mneuroth/heizungsregelung-public/heatcontrol_firmware/README.md

## Firmware für Heizungsregelung mit Heizungsplatine und Raspberry Pi

Diese Firmware ist aktuell.
