mneuroth/heizungsregelung-public/documentation/SchaltplanHeizungsreglung.odp

RS232 Konverter Platine

MAX3232

UART Konverter

MAX3232

UART Konverter

Conrad Relaiskarte

Vin = 12..24 Volt

Arduino Platine

Arduino

+5V (V_ref)

NTC20

(Sensor)

R2 (11kΩ)

A1..A12 (Analog Input)

PT1000

(Sensor)

R2 (1kΩ||11kΩ),

1kΩ

A0, A9 (Analog Input)

Serial (Pin 0, 1)

Vin = 7..12 Volt

Serial1 (Pin 18, 19)

Digital Out: Pin 13 (on board LED), 7 (external LED), 6 (not used)

+5V (V_ref)

Temperatur Sensoren (13 Stück)

Schaltbare 230V Ausgänge (8 Stück)

230 Volt Platine

Vin = 230 Volt

Vin = 5 Volt

UART2,

Baud=19200,

8bit,

Parity=None

Stop=1,

Timeout=5sec

UART1,

Baud=19200,

8bit,

Parity=None

Stop=1,

Timeout=2sec

Friendly

ARM

UART0, (DEBUG: RS232 9Pin)

Baud=115200,

8bit,

Parity=None

Stop=1,

Timeout=5sec

Vin = 5 Volt

LAN
