mneuroth/heizungsregelung-public/documentation/DokumentationRegelung.pdf

## Regelung Ist Zustand (5.5.2010)

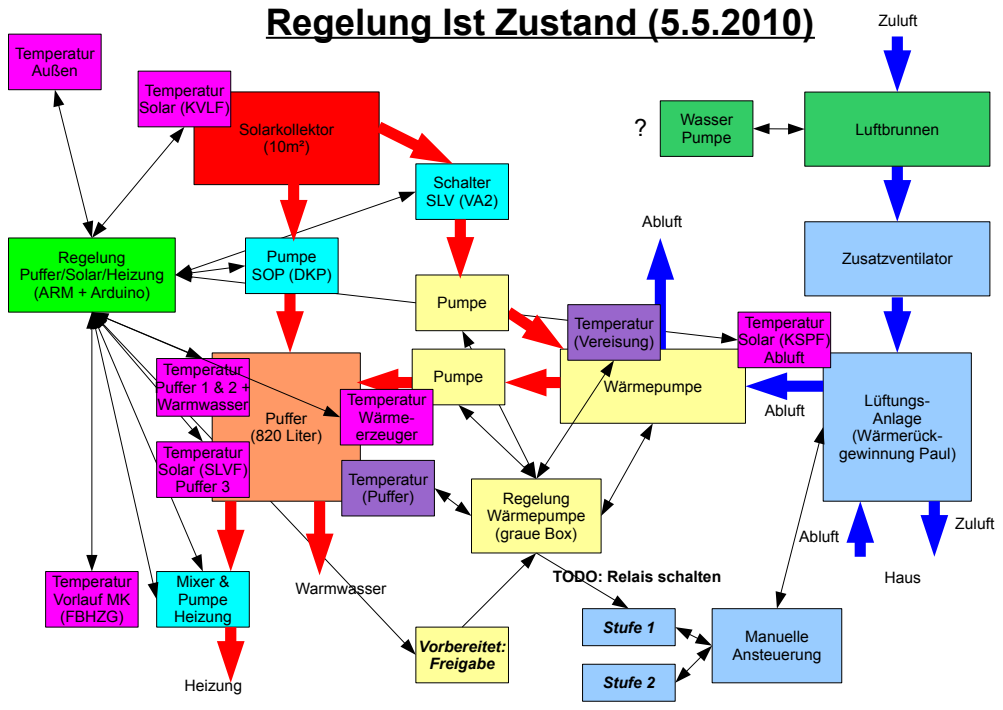
[picture p19: page 1]
Solarkollektor (10m²); Puffer (820 Liter); Wärmepumpe; Lüftungs- Anlage (Wärmerück- gewinnung Paul); Zusatzventilator; Zuluft; Luftbrunnen; Haus; Abluft; Warmwasser; Heizung; Regelung Wärmepumpe (graue Box); Pumpe SOP (DKP); Mixer & Pumpe Heizung; Temperatur Puffer 1 & 2 + Warmwasser; Temperatur Solar (KVLF); Temperatur (Puffer); Pumpe; Temperatur Außen; Manuelle Ansteuerung; Temperatur (Vereisung); Wasser Pumpe ?; Schalter SLV (VA2); Temperatur Solar (KSPF) Abluft; Stufe 1; Stufe 2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

Regelung
Puffer/Solar/Heizung
(ARM + Arduino)

Temperatur erzeuger | Wärme-

Temperatur Solar (SLVF) Puffer 3

TODO: Relais schalten

## Eingänge: Temperatur Sensoren:

ADC-Nr | Name | ID | used
0 | Solar / KVLF (Solar Collector) | SOLAR_KVLF | X
1 | Puffer 3 / SLVF (Solar Buffer 3) | SOLAR_SLVF | X
2 | Außen (Outdoor) | OUTDOOR | (X)
3 | Mixer / Vorlauf MK (FBHZG) (Act. heat) MIXER_HEATING | X
4 | Puffer 1 (Buffer 1) | BUFFER1
5 | Puffer 2 (Buffer 2) | BUFFER2
6 | Abluft / Solar KSPF (Outgoing Air) | HEATPUMP_OUTGOING_AIR
7 | Warmwasser | WARM_WATER
8 | Waermeerzeuger | HEAT_CREATOR
9 | Ingoing Air <not connected yet> | INGOING_AIR
10 | Licht Sensor 1 <not used>
11 | Licht Sensor 2 <not used>
12 | Vereisung
13
14
15

## Ausgänge: Relais:

Relais-Nr | Name | ID
0 | Solar Motor / SOP DKP | MOTOR_SOLAR
1 | Heating Motor | MOTOR_HEATING
2 | Waermepumpe | HEATPUMP
3 | Lueftungsanlage / Bypass | VENTILATION
4 | Ventil Waermepumpe / Solarbetrieb / SLV VA2 HEATPUMP_SOLAR_VALVE
5 | Booster / Warmwasser Zirkulationspumpe | BOOSTER
6,7 | Mixer | MIXER_HEATING

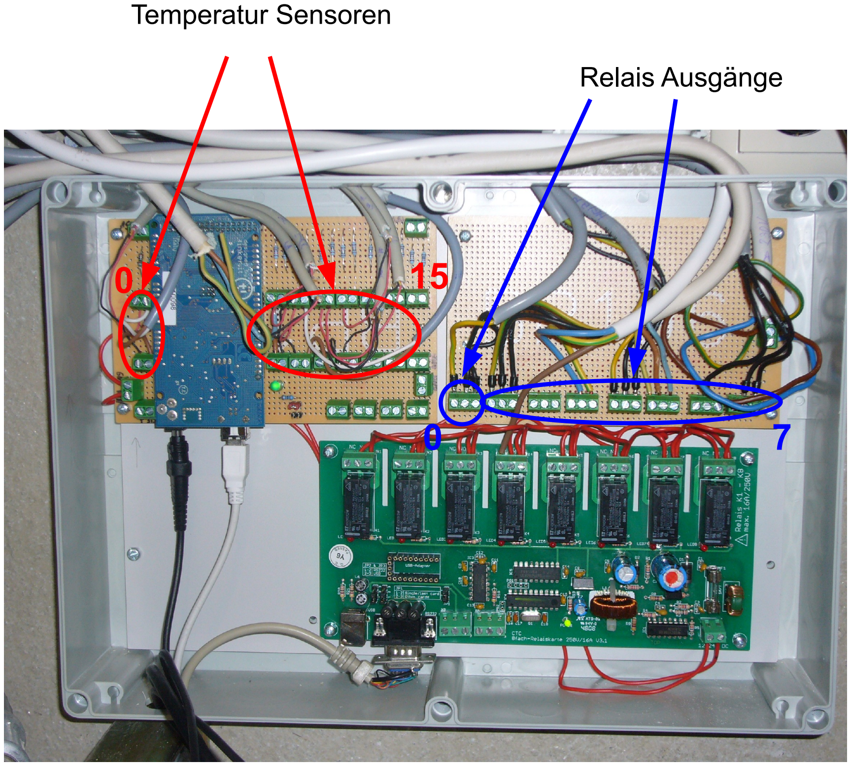
[picture p20: page 4]

Temperatur Sensoren

Relais Ausgänge

0 15

0 7

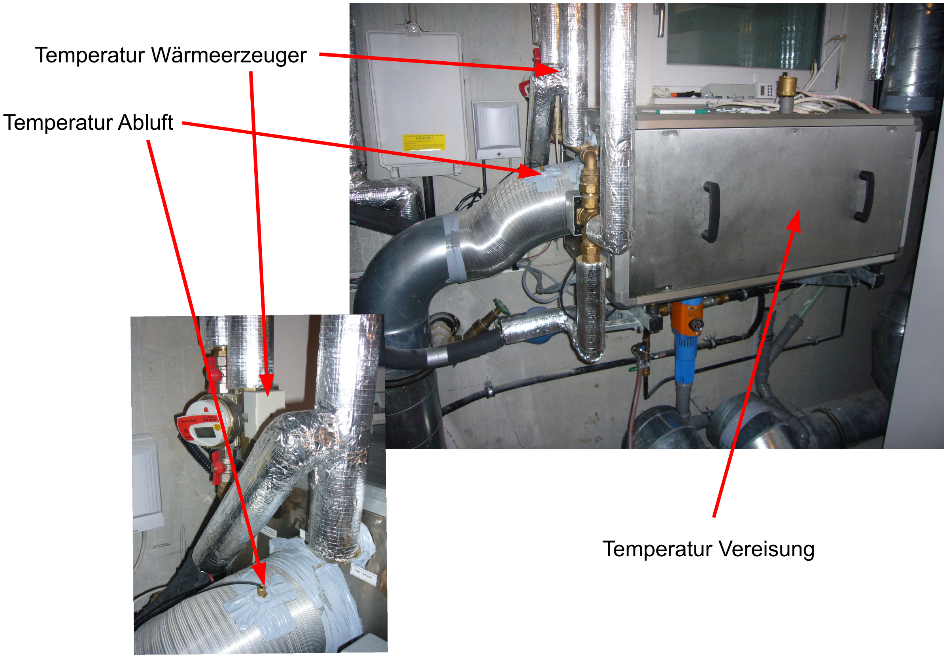
[picture p21: page 5]

Temperatur Wärmeerzeuger

Temperatur Abluft

Temperatur Vereisung

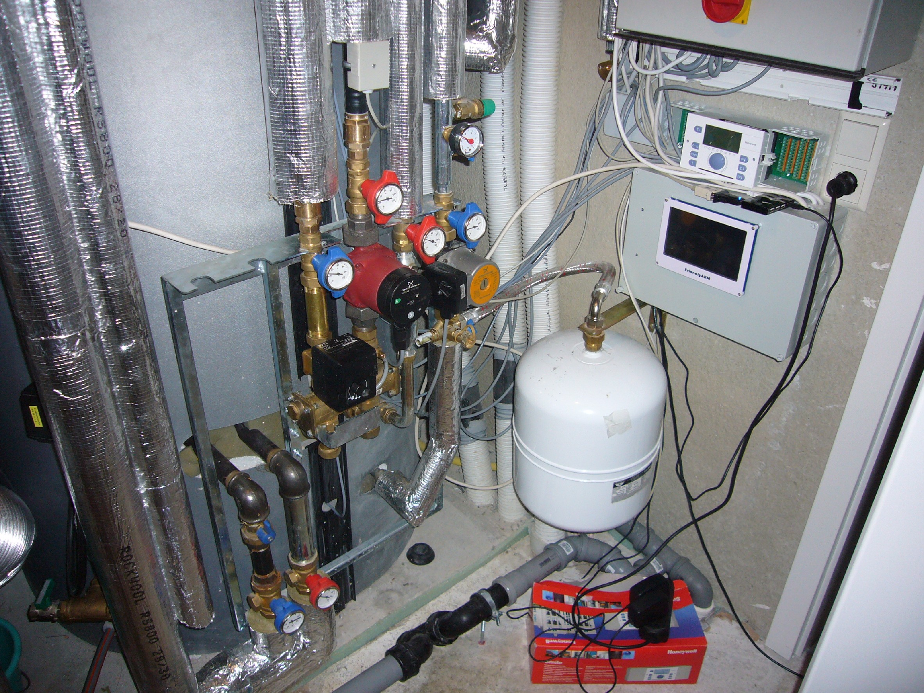
[picture p22: figure]
