mneuroth/heizungsregelung-public/bilder/README.md

## Gesamt System

Foto des gesamten Systems
