mneuroth/heizungsregelung-public/documentation/README.md

## Allgemeine Dokumentation des Heizungsregelungs Projekts

Dieses Verzeichnis enthält Dokumentation und Datenblätter für das Heizungsregelungs Projekt.
