mneuroth/heizungsregelung-public/platine/README.md

## Schaltpläne für die Heizungsregelungs Platine

Programm zur Bearbeitung der Schaltpläne (Stromlaufplan und Layout) muss das Programm [Target3001](https://www.ibfriedrich.com/de/index.html) verwendet werden.
