mneuroth/heizungsregelung-public/strompi2/README.md

# Strompi2

Dieses Verzeichnis enthält die original Dokumentation der [Strompi2 Platine](https://joy-it.net/de/products/rb-StromPi2).
