mneuroth/heizungsregelung-public/documentation/ScanHeizungsregelungDoku.pdf

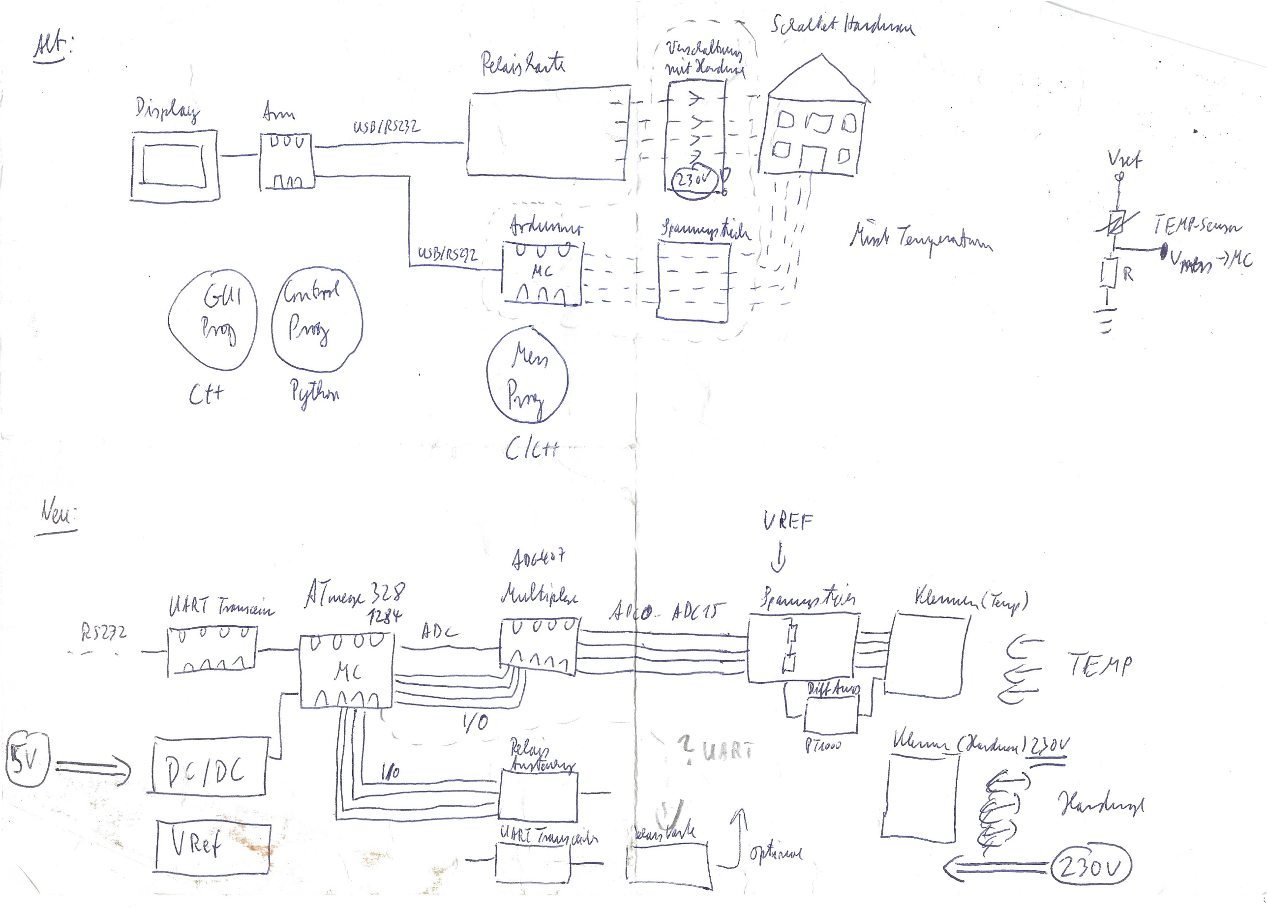
[picture p26: page 1]
