mneuroth/heizungsregelung-public/documentation/Schaltplan230VoltPlatine_Heizungsregelung.pdf

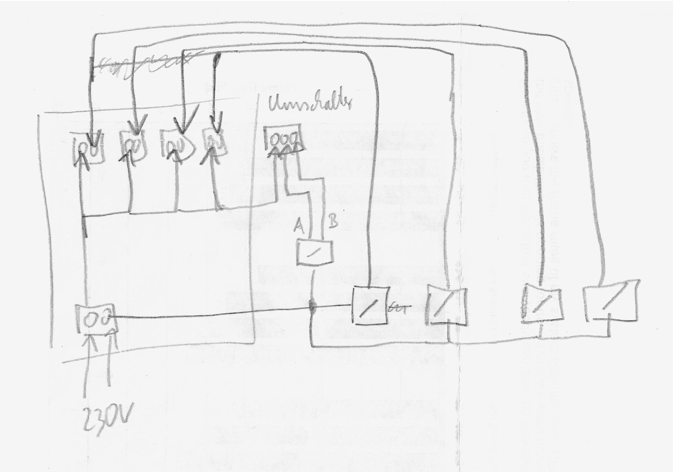
[picture p27: page 1]
