mneuroth/heizungsregelung-public/documentation/SchaltplanUARTConverter_Heizungsregelung.pdf

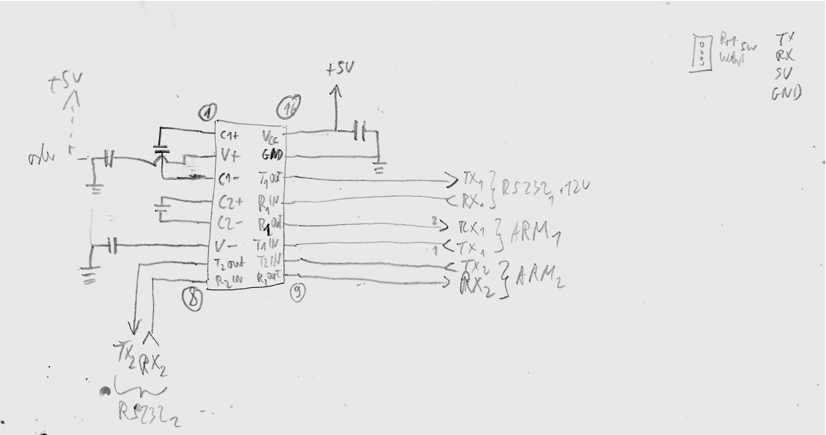
[picture p28: page 1]
