mneuroth/heizungsregelung-public/bilder/http_client_help.png

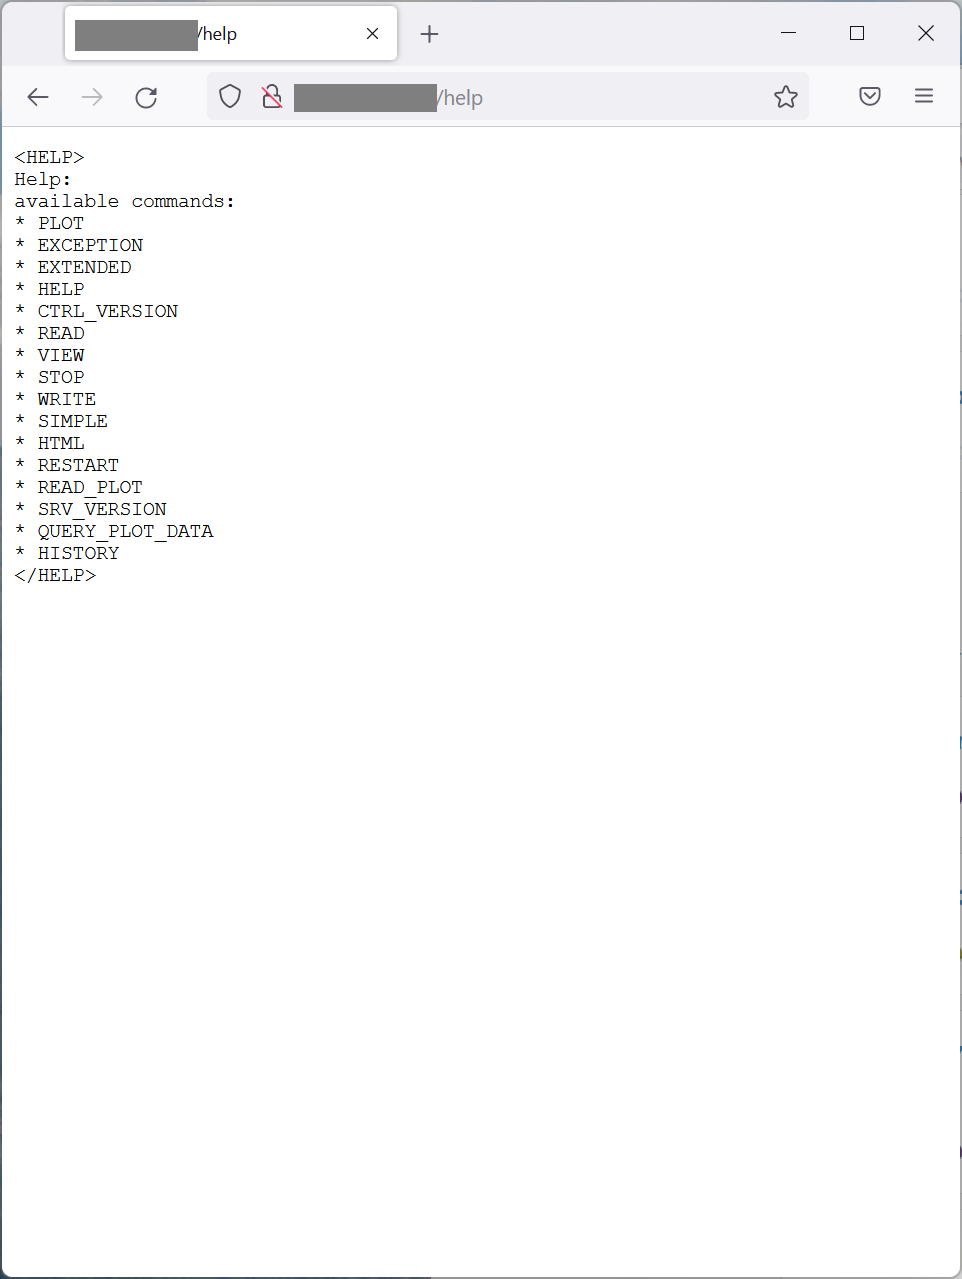
bilder/http_client_help.png
