mneuroth/heizungsregelung-public/bilder/P1100033.JPG

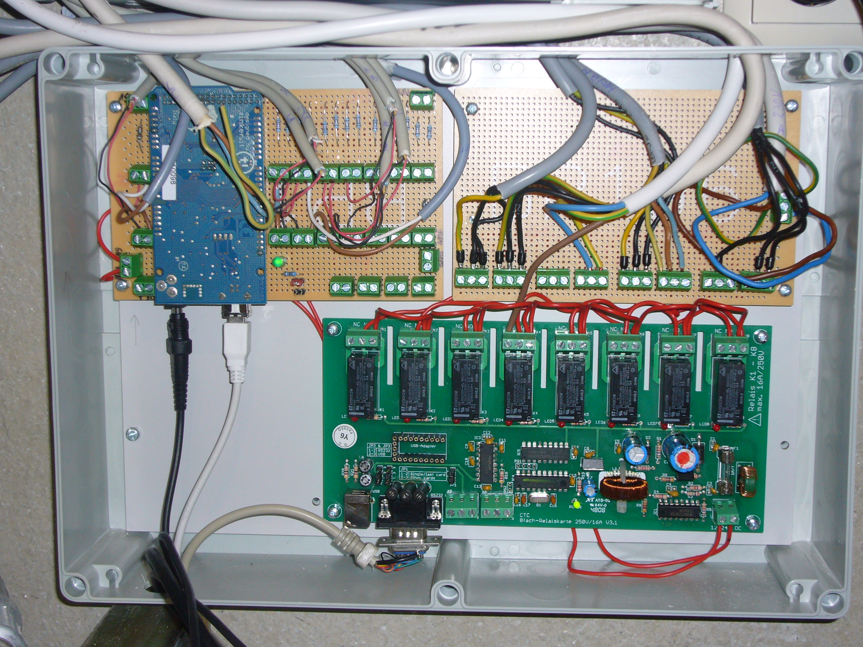
bilder/P1100033.JPG
