mneuroth/heizungsregelung-public/documentation/BlockDiagrammSoftware.png

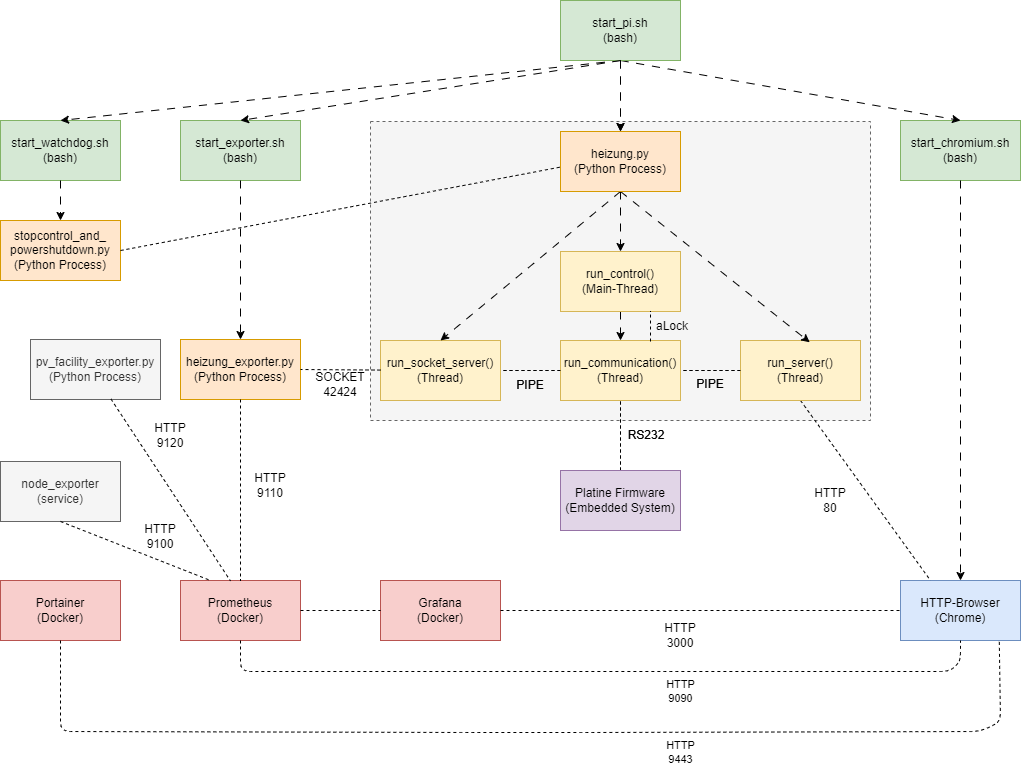
documentation/BlockDiagrammSoftware.png
