mneuroth/heizungsregelung-public/documentation/RegelungIstZustand.png

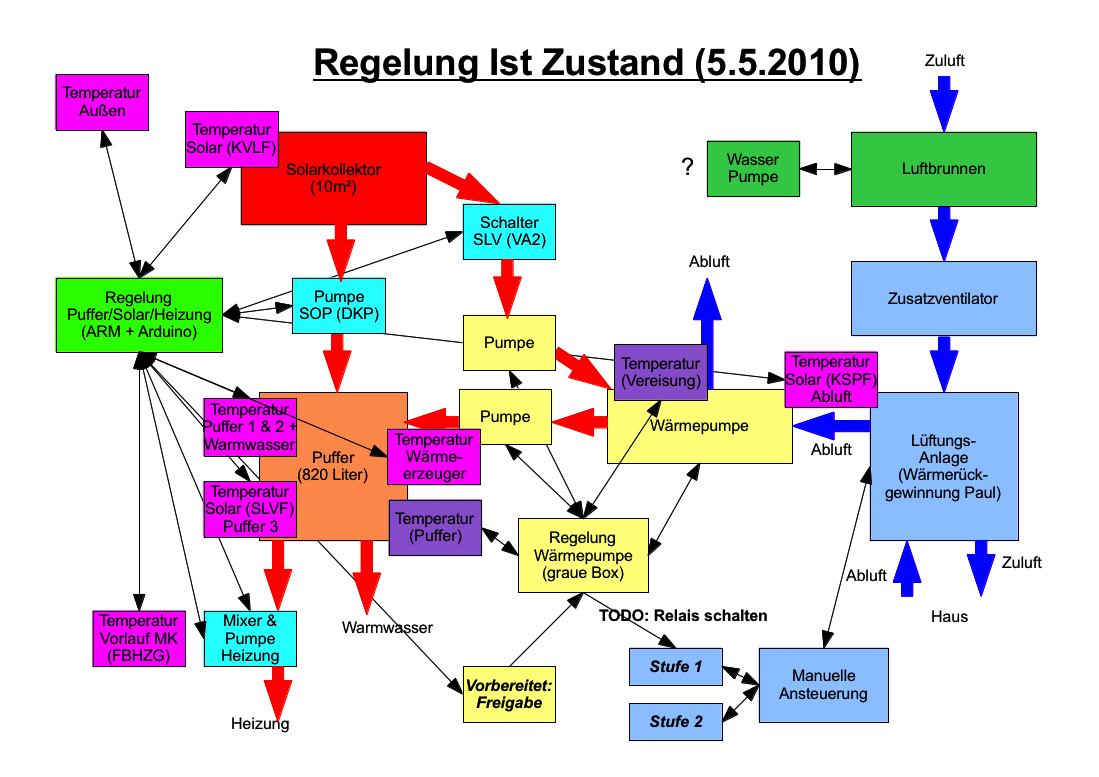
documentation/RegelungIstZustand.png
