mneuroth/heizungsregelung-public/documentation/SchaltplanHeizungsreglung.png

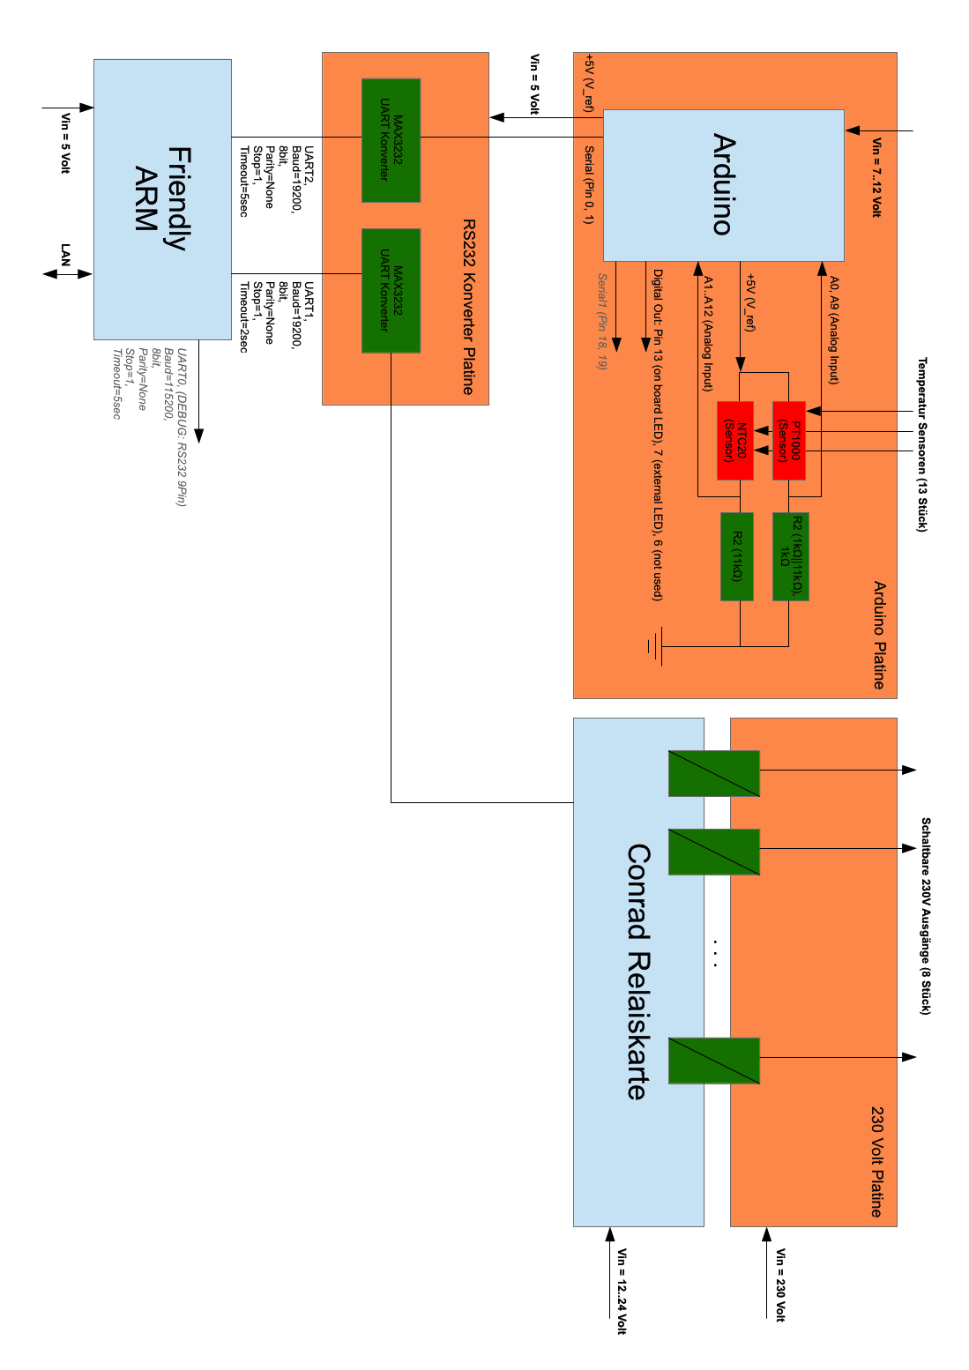
documentation/SchaltplanHeizungsreglung.png
