mneuroth/heizungsregelung-public/documentation/two_spi_devices.png

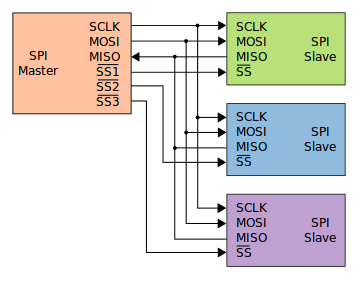
documentation/two_spi_devices.png
