mneuroth/heizungsregelung-public/documentation/VergleichQualityADC_MCP3008_ATMega32_mcp(blue)_with_mcadc(orange)_b.png

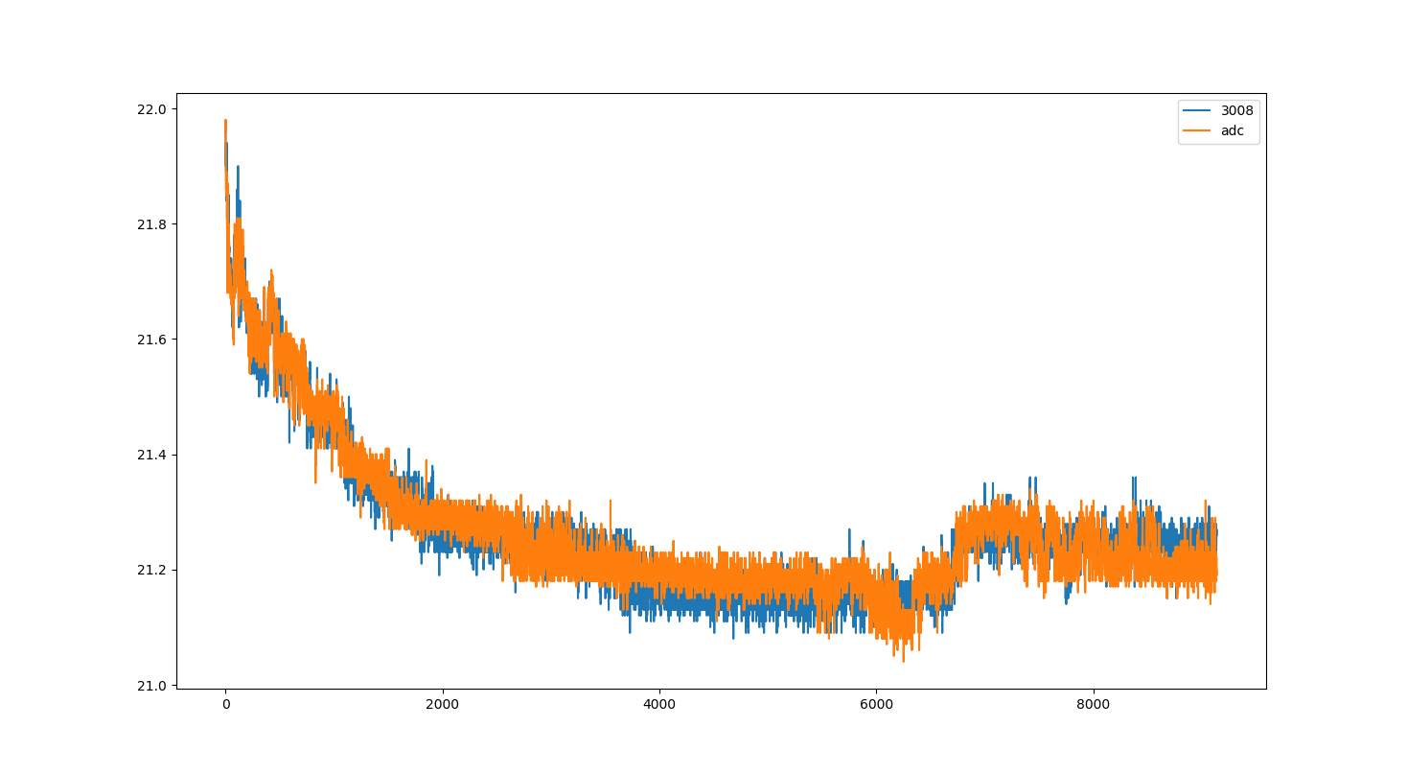
documentation/VergleichQualityADC_MCP3008_ATMega32_mcp(blue)_with_mcadc(orange)_b.png
