mneuroth/heizungsregelung-public/documentation/VergleichQualityADC_MCP3008_normal(blue)_with_averaged(orange)_b.png

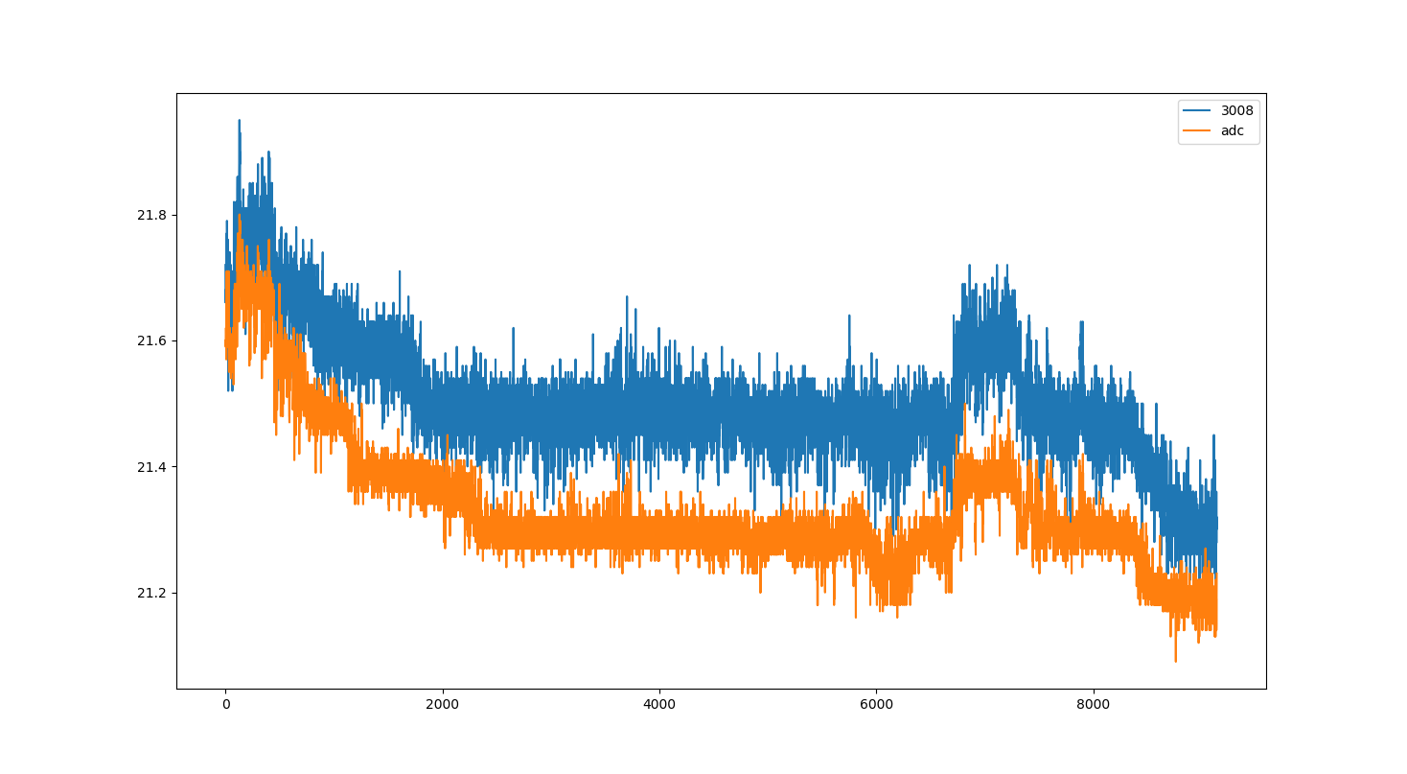
documentation/VergleichQualityADC_MCP3008_normal(blue)_with_averaged(orange)_b.png
