mneuroth/heizungsregelung-public/platine/heizungNeuV1_2_final_3D.png

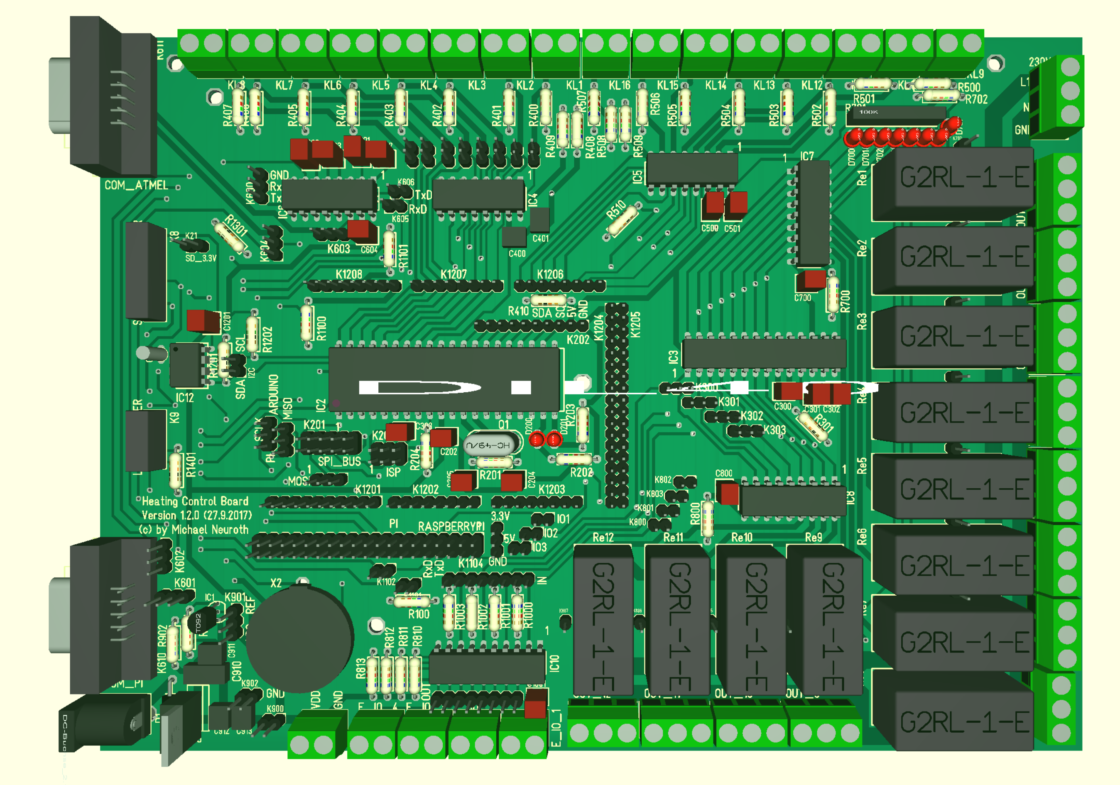
platine/heizungNeuV1_2_final_3D.png
