mneuroth/heizungsregelung-public/platine/RS232_nullmodem_pins.png

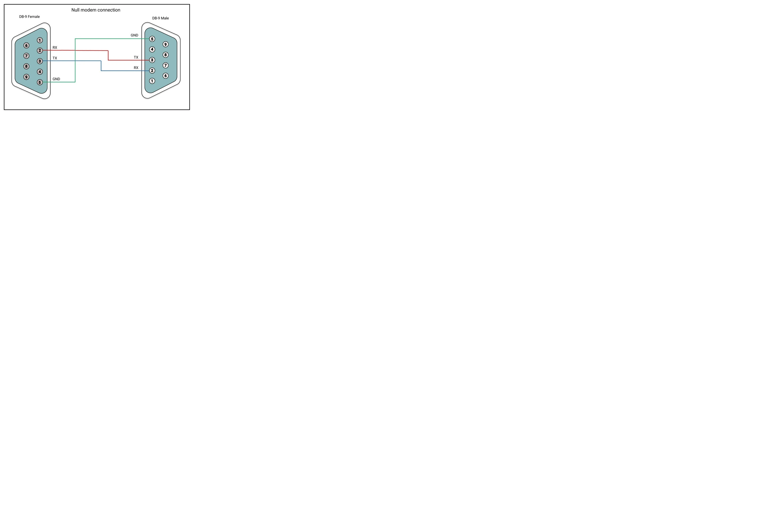
platine/RS232_nullmodem_pins.png
