mneuroth/heizungsregelung-public/platine/heizungNeuV1_2_final_SCH.PDF

RS232 | für | PI

## Max Current an 5V --> 1 mA

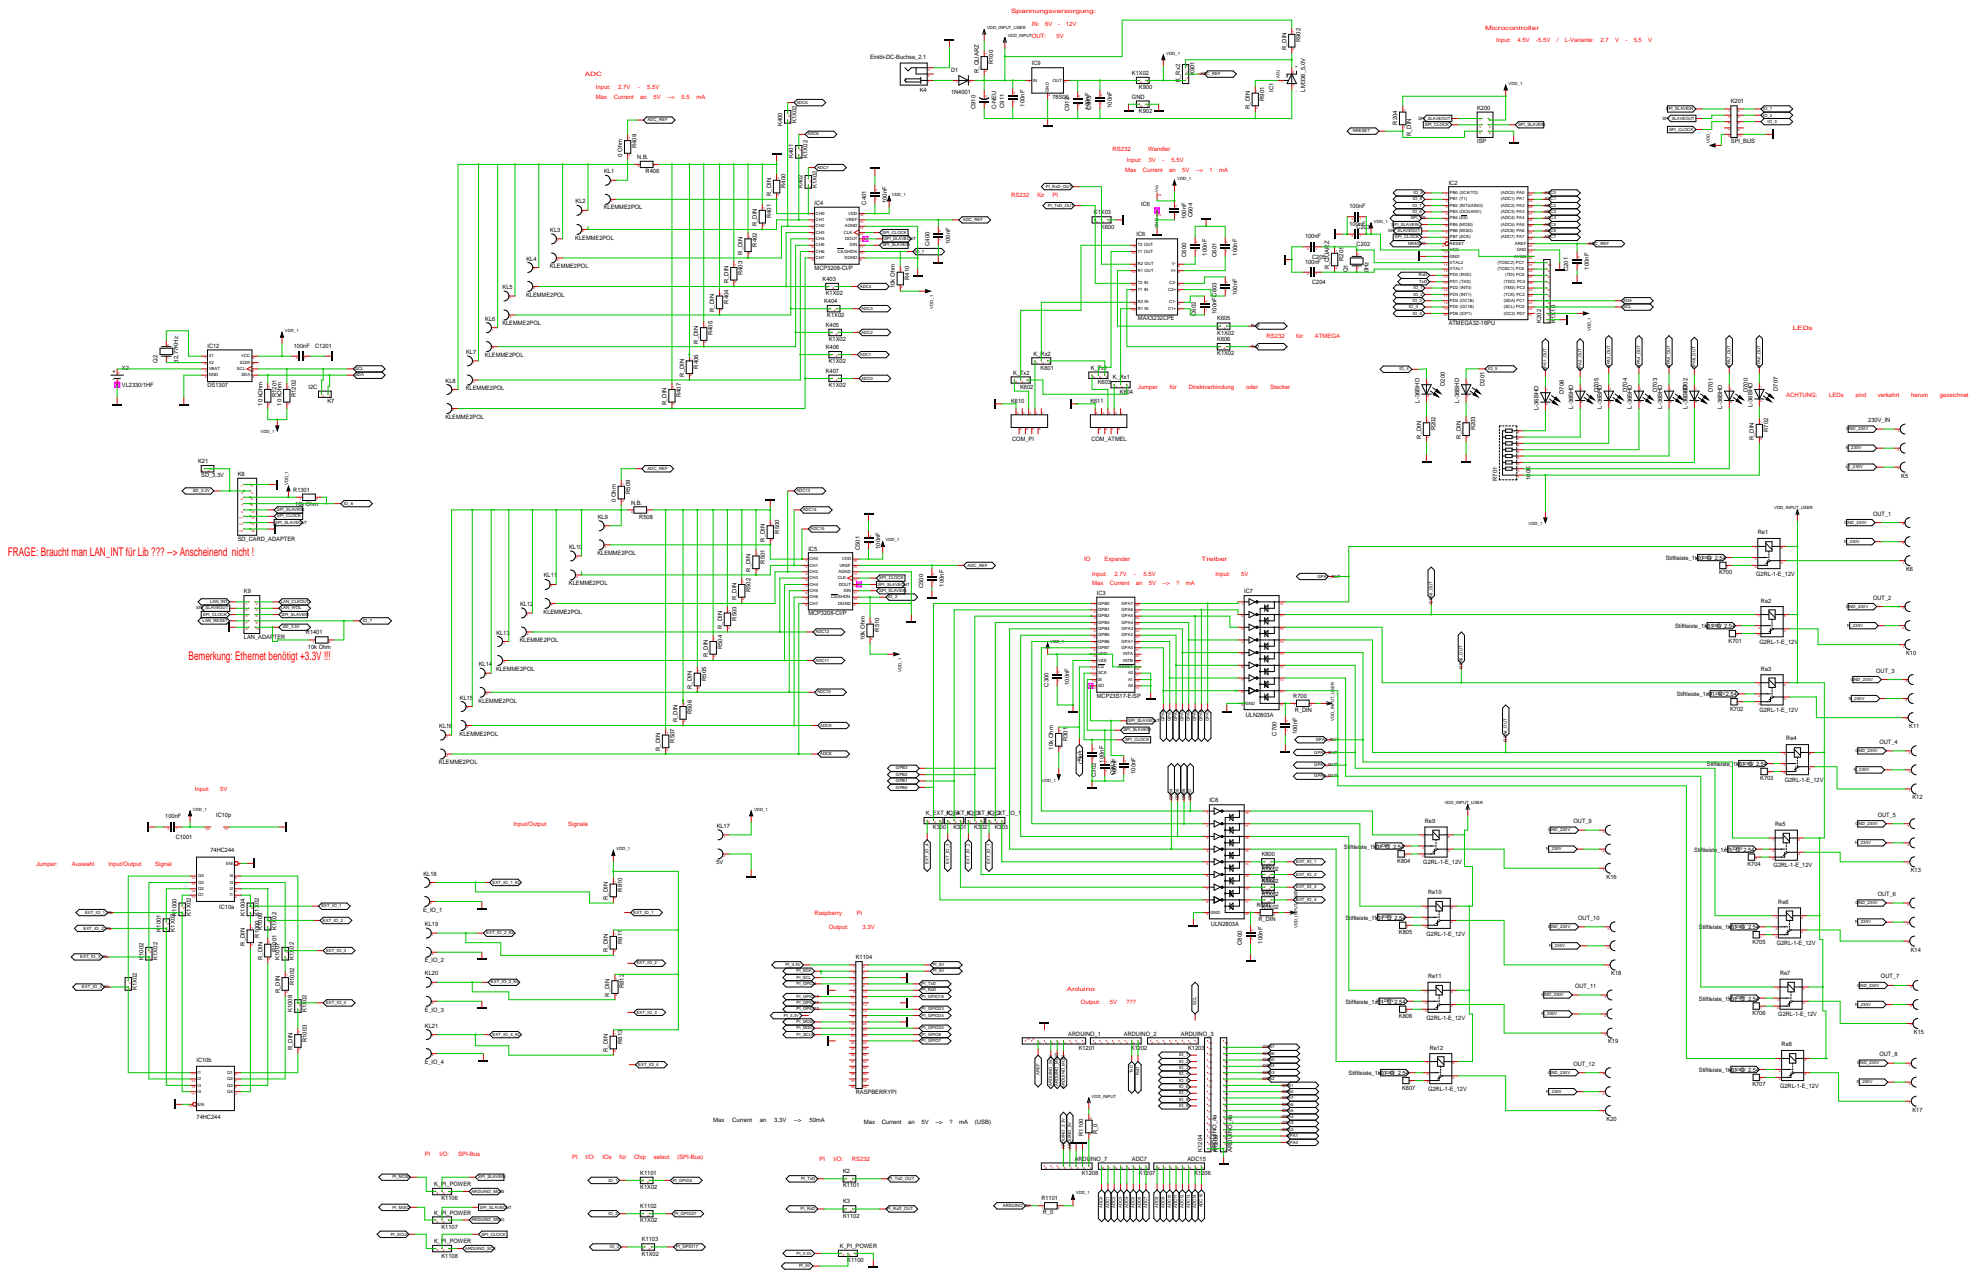
[picture p40: page 1]

Max Current an 5V --> 0.5 mA

FRAGE: Braucht man LAN_INT für Lib ??? --> Anscheinend nicht !

Max Current an 5V --> ? mA
