mneuroth/heizungsregelung-public/platine/heizungNeuV1_2_final_PCB.PDF

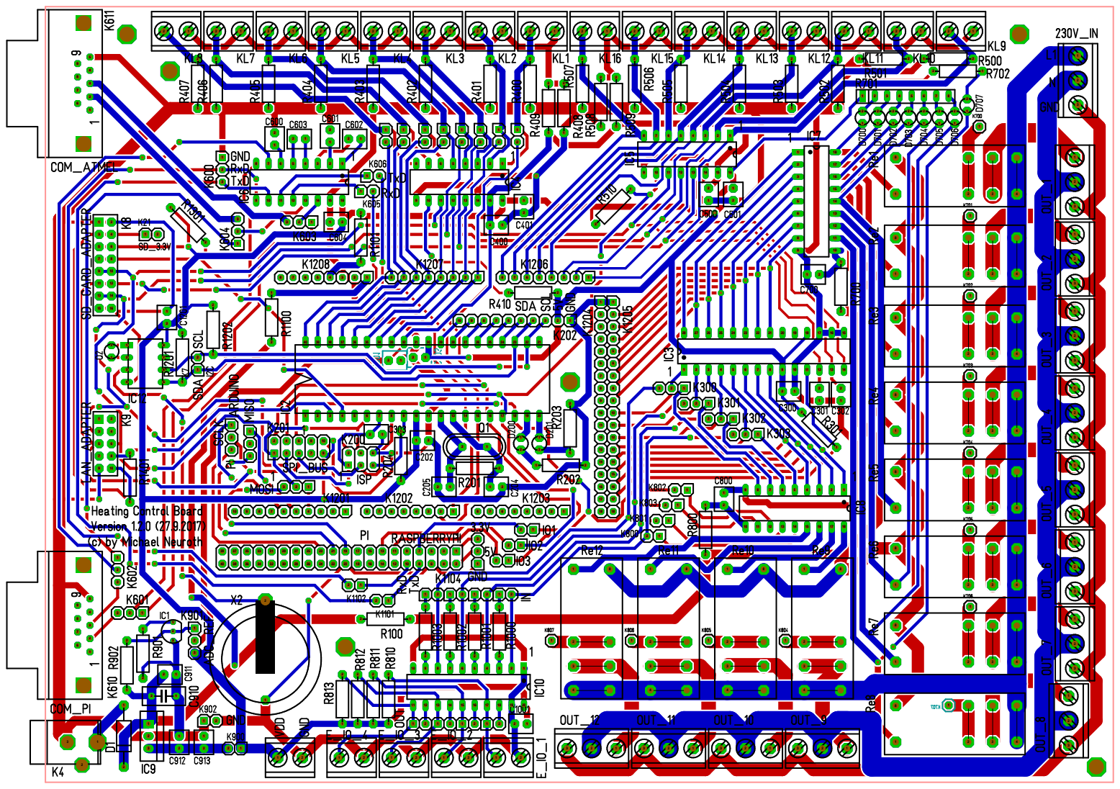
[picture p41: page 1]
