mneuroth/heizungsregelung-public/heizung.py

# -*- coding: utf-8 -*-
r""" 
   ****************************
   * Heating control program. *
   ****************************

   Test mode:
   ----------
    >python heizung.py -t

   All options:
   ------------
    > python heizungsregelung.py -h
    >
    > heating control programm, available options:
    > -s : silent modus, no debugging output
    > -i : use simulation port 8008 for http
    > -p : use default port 80 for http
    > -t : test without hardware (simulate hardware)
    > -e : use exclusive access modus for RS232 interface
    > -c : run with history cache
    > -d : run without history cache
    > -w : disable watchdog in python program
    > -h : show this help   

   Info:
   - Values of manual switches are cached in directory /sdcard/cache or ./cache
   - Plot history is cached in directory /sdcard/cache or ./cache
   - State of manual switches are stored in directory /sdcard/persistence or ./persistence

   ************************************************************************
   
    Class Overview:
    ===============
    
    object
      |
    Device
      |
    Rs232Device
      |
    ArduinoMega   ConradMultiRelais   HeatingControlBoard   # used by SignalProcessor instances
      
    
    object
      |
    ResouceScope
    

    list
      |
    ControlEngine
      
    
    object
      |
    SignalProcessor
      |       |
      |     TemperatureMeasurement  RelaisMeasurement  DataSource  ThermicalSolarCollectorControl            HeatingControl         
      |                                                  |                                                     |
      |                                                TickCounterSource  TemperatureSource  LightSource     DesiredValueForHeatingMixerControl
      |
    HeatingMixerControl  HeatPumpControl  VentilationControl  HeatPumpSolarValveControl  ManualSwitch  ManualSwitchAutoReset  SwitchRelais  ThreeStateSwitchRelais  ValueSwitch  NotNode  OrNode  AndNode  OperatingHoursCounter  EnableTimer  Watchdog  Timeline
    
    =======================================================================
    
    ControlEngine = [SignalProcessor,...]	# manages a list of SignalProcessor objects, is the time processor --> clock_tick()
    
    SignalProcessor 			        # has InputSignals==SignalProcessor and a Timeline (history output values) (OutputSignals only for debugging == Graph Analysis)
                                        # uses the InputSignals to get values which will be used in the clock_tick() method to calculate my own (output) clock_tick-value
                                        # this (output) clock_tick-value could be used as input value for other SignalProcessor objects
                                     
    Example:
    --------    
                                                                      RelaisMeasurement
                                                                              ^
                                                                              .
    TemperatureSource (SOLAR_SLVF) --\                                        . uses
                                      \ 					                  .
    TemperatureSource (SOLAR_KVLF) --> ThermicalSolarCollectorControl --> SwitchRelais (SWITCH_MOTOR_SOLAR)
       .                                                                 /
       . uses                                            ManualSwitch --/ (MANUAL_SWITCH_MOTOR_SOLAR)
       .
       V
    TemperatureMeasurement
    
    
    TemperatureMeasurement   		    # has no logical input, just for temperature measurement in a clock_tick() (side effect!) 
    
    ThermicalSolarCollectorControl		# uses the two input nodes to get values for temperatures and calculates an output value 
                                          (nothing will be done with this value, except any other node has this node as an input node,
                                           in this case the values of this node will be used in the other node to calculate a value
                                           for the other node)
                                           
    -----------------------------------------------------------------------

    QtControlGui   <---http--->   SimpleServer    ---queue--->   ControlProcess
                                    Py-Proc      <---queue---       Py-Proc
                                                    
                                                 MainProcess
                                                   Py-Proc
                                                   
 
    Design-Info:
    ============

    the heizung application has 3 different (asynchroniously running) loops:
                                                                                                  |
       Control-Loop (Main-Thread)   <----------->  HttpCommunicationThread (Worker-Thread)    <=======>    HttpServerThread (Worker-Thread)
                                     Vars & Lock                                                Queue
                                                                                                  |
                                                                                       option (A): two different processes
                                                                                       option (B): one process, but multipe threads

"""

import sys
import os
import os.path
import io
#import getpass
import glob
import datetime
import time
import functools
import math
import traceback
import signal

import serial
import requests
import json

import paho.mqtt.client as mqtt

from functools import wraps

import pipeprocessing

import socket
import selectors
import libserver

from file_utils import *

try:
    from StringIO import StringIO
except:
    from io import StringIO

g_bUseThreads = True    # True  --> run control and http-server in one process in different threads (communicate via Queue)
                        # False --> run control and http-server in different processes. the control procress has two threads for control-loop and http-communication-loop (to communicate with http-server) (communicate via multiprocessing.Queue)

if not g_bUseThreads:
    try:
        from multiprocessing import Queue, Process #, freeze_support
    except ImportError as e:
        print( e )
        print( "using threading module !" )
        from threading import Thread as Process    
        from queue import Queue
        Process.is_alive = Process.isAlive   
        #freeze_support = lambda : True
else:
    try:
        from queue import Queue
    except:
        # for Raspberry Pi Python 2.7.13
        from Queue import Queue

import threading

if  sys.version_info.major==3:
    import _thread as thread    # for python 3
else:
    import thread               # for python 2

# *************************************************************************

LAYER_UNKNOWN = 'LAYER_UNKNOWN'
LAYER_INPUT = 'LAYER_INPUT'
LAYER_MANUAL_SWITCH = 'LAYER_MANUAL_SWITCH'
LAYER_CONTROL = 'LAYER_CONTROL'
LAYER_OUTPUT = 'LAYER_OUTPUT'

g_bCanControlHeatingControlBoard = False
try:
    import RPi.GPIO as GPIO
    GPIO.setmode(GPIO.BCM)
    GPIO.setwarnings(False)
    g_bCanControlHeatingControlBoard = True
except ImportError as e:
    print( "Warning: Not running on Raspberry Pi, can not control HeatingControlBoard !" )
    
def SwitchHeatingControlBoard(bOn):
    if g_bCanControlHeatingControlBoard:
        GPIO.output(4, GPIO.LOW if bOn else GPIO.HIGH)
        return True
    else:
        # function not supported
        return False

# *************************************************************************

def is_raspberrypi():
    try:
        with io.open('/sys/firmware/devicetree/base/model', 'r') as m:
            if 'raspberry pi' in m.read().lower():
                return True
    except Exception: 
        pass
    return False

# only fallback constants, devices will be queried
if os.name=="posix" and sys.platform=="darwin":
    # for MacOS:
    DEVICE_RS232_ARDUINO = "/dev/tty.usbserial-A900acbK"
    DEVICE_RS232_RELAIS  = "/dev/tty.usbserial-A800em6n"
    DEVICE_RS232_HEATINGCONTROLBOARD = "/dev/tty.usbserial-A900acbK"
elif os.name=="posix":
    # for Friendlyarm:
    DEVICE_RS232_ARDUINO = "/dev/ttySAC2"
    DEVICE_RS232_RELAIS  = "/dev/ttySAC1"
    DEVICE_RS232_HEATINGCONTROLBOARD = "/dev/ttySAC2"
    if os.uname()[1]=="raspberrypi" or os.uname()[1]=="heizungsregelung" or is_raspberrypi():
        # for Raspberry Pi:
        DEVICE_RS232_HEATINGCONTROLBOARD = "/dev/serial0"
        DEVICE_RS232_ARDUINO = "/dev/serial0"
        DEVICE_RS232_RELAIS  = "/dev/serial0"
elif os.name=="nt":
    # for Windows:
    DEVICE_RS232_ARDUINO = "COM12"   # org: 2
    DEVICE_RS232_RELAIS  = "COM13"   # org: 3
    DEVICE_RS232_HEATINGCONTROLBOARD = "COM7"

# *************************************************************************
__version__ = "2.9.3"
__date__    = "30.1.2026"
# *************************************************************************
START_YEAR = 2010

g_support_heatpump_via_pv = True

g_bDebug = True
g_bSimPort = False
g_bUseHttpDefaultPort = False
g_bTest = False
g_bExclusiveRs232 = False
g_bUseCache = True
g_bUseWatchdog = False
g_bDumpDependencyGraph = False
g_actUsbRs232Devices = []

IP_OF_MQTT_BROKER = "127.0.0.1" # localhost # or: "192.168.178.40"

# MQTT Temperature Names
MQTT_TEMPERATURE_NAMES = ['TEMP_MEAS','LIGHT1','LIGHT2','SOLAR_KVLF','SOLAR_SLVF','OUTDOOR','MIXER_HEATING','BUFFER1','BUFFER2','OUTGOING_AIR','WARM_WATER','HEAT_CREATOR', 'CONVERTER', 'ROOM', 'TESTSENSOR_PT1000', 'ESP32_HTTP_TEMP']
MQTT_MANUAL_SWITCH_NAMES = ['MANUAL_SWITCH_MOTOR_SOLAR','MANUAL_SWITCH_MOTOR_HEATING','MANUAL_SWITCH_HEATING_ONLY_NIGHT','MANUAL_SWITCH_HEATING_DATE','MANUAL_SWITCH_MAX_TEMP_CONTROL','MANUAL_SWITCH_MIXER_HEATING','MANUAL_SWITCH_HEATPUMP','MANUAL_SWITCH_VENTILATION','MANUAL_SWITCH_HEATPUMP_SOLAR_VALVE','MANUAL_SWITCH_BOOSTER','MANUAL_SWITCH_HEATPUMP_ONLY_WITH_PV']
# Remark: MANUAL_SWITCH_MIXER_HEATING has Open, Close Stop states
MQTT_SWITCH_NAMES = ['SWITCH_MOTOR_SOLAR','SWITCH_MOTOR_HEATING','SWITCH_MIXER_HEATING','SWITCH_HEATPUMP','SWITCH_VENTILATION','SWITCH_HEATPUMP_SOLAR_VALVE','SWITCH_BOOSTER']
MQTT_CONTROL_NAMES = ['SOLAR_CONTROL','HEATING_CONTROL','MIXER_HEATING_CONTROL','HEATPUMP_CONTROL','VENTILATION_CONTROL','HEATPUMP_SOLAR_VALVE_CONTROL','ENABLE_MIXER_MAX_TEMP_CONTROL']
MQTT_OPERATING_HOURS_NAMES = ['OPERATING_HOURS_HEATPUMP','OPERATING_HOURS_MOTOR_HEATING','OPERATING_HOURS_MOTOR_SOLAR']
MQTT_INTERVAL_NAMES = ['ENABLE_HEATING_MOTOR_INTERVALS','ENABLE_HEATING_MOTOR_NIGHT_INTERVALS','ENABLE_MIXER_CLOSE_INTERVALS','ENABLE_DATE_HEATING_MOTOR_INTERVALS','ENABLE_ANTI_FIXING_SWITCH_INTERVALS','ENABLE_HEAT_PUMP_FOR_PV_INTERVALS']

def get_index_for_name(name, name_list):
    try:
        val = name_list.index(name)
        return val
    except ValueError:
        return -1

def get_indizes_for_all_names(name_list, all_names):
    ret = []
    for name in name_list:
        ret.append( get_index_for_name(name, all_names) )
    return ret

def is_debug():
    return g_bDebug

def set_debug(bValue):
    global g_bDebug
    g_bDebug = bValue

def set_test(bValue):
    global g_bTest
    g_bTest = bValue

def set_exclusive_rs232(bValue):
    global g_bExclusiveRs232
    g_bExclusiveRs232 = bValue

def set_sim_port(bValue):
    global g_bSimPort
    g_bSimPort = bValue

def set_default_http_port(bValue):
    global g_bUseHttpDefaultPort
    g_bUseHttpDefaultPort = bValue

def set_use_cache(bValue):
    global g_bUseCache
    g_bUseCache = bValue

def set_use_watchdog(bValue):
    global g_bUseWatchdog
    g_bUseWatchdog = bValue
    
def set_dump_dependency_graph(bValue):
    global g_bDumpDependencyGraph
    g_bDumpDependencyGraph = bValue

def find_win32_rs232_devices():
    ret = []
    for i in range(255):
        try:
            aCOM = serial.Serial("COM"+str(i+1))    # PATCH for new pySerial version
            ret.append("COM"+str(i+1))
        except serial.SerialException:
            pass
    return ret
    
def get_mapped_usb_rs232_devices():
    return g_actUsbRs232Devices

def update_mapped_usb_rs232_device(sOldName,sNewName):
    aLst = get_mapped_usb_rs232_devices()
    if sOldName in aLst:
        aLst.remove(sOldName)
    aLst.append(sNewName)

def find_all_usb_rs232_devices():
    if os.name == 'nt':
        return find_win32_rs232_devices()
    elif os.name == 'posix' and sys.platform=='darwin':
        return glob.glob("/dev/tty.usbserial*")
    elif os.name == 'posix':
        return glob.glob("/dev/ttyUSB*")
    else:
        return []        

def get_new_not_used_usb_rs232_devices(sMyOldRs232Name):
    lstMaybeUsedRs232 = []
    # hole alle /dev/ttyUSB* namen aus dem aktuellen daten
    # ausser dem uebergebenen namen, der gerade ungueltig geworden ist
    for key in get_mapped_usb_rs232_devices():
        if key!=sMyOldRs232Name:
            lstMaybeUsedRs232.append(key)
    # entferne aus der liste der aktuell verfuegbaren USB devices die wahrscheinlich verwendeten devices
    ret = []
    for e in find_all_usb_rs232_devices():
        if not (e in lstMaybeUsedRs232):
            ret.append(e)
    return ret
    
def find_rs232_device_for_hardware_class(aLstDevices,aHardwareClass,baudrate,bytesize,parity,stopbits,timeout):
    for e in aLstDevices:
        aHardware = aHardwareClass(e,baudrate,bytesize,parity,stopbits,timeout)
        if aHardware.is_ok() and aHardware.ping():
            update_mapped_usb_rs232_device("",e)
            aLstDevices.remove(e)
            return (aLstDevices,aHardware)
        else:
            aHardware.close()
            aHardware = None
    return (aLstDevices,None)

# see: https://stackoverflow.com/questions/15389768/standard-deviation-of-a-list
def stddev(lst):
    try:
        if len(lst)>0:
            mean = float(sum(lst)) / len(lst)
            return math.sqrt(float(reduce(lambda x, y: x + y, map(lambda x: (x - mean) ** 2, lst))) / len(lst))
    except:
        return -1.0
    return 0.0

def _node_type_to_shape(node_type):
    if node_type == LAYER_INPUT:
        return 'ellipse'
    elif node_type == LAYER_CONTROL:
        return 'parallelogram'
    elif node_type == LAYER_MANUAL_SWITCH:
        return 'house'
    elif node_type == LAYER_OUTPUT:
        return 'hexagon'
    return 'box'
   
def _node_type_to_color(node_type):
    if node_type == LAYER_INPUT:
        return 'orange'
    elif node_type == LAYER_CONTROL:
        return 'blue'
    elif node_type == LAYER_MANUAL_SWITCH:
        return 'red'
    elif node_type == LAYER_OUTPUT:
        return 'green'
    return 'black'

def check_type(s):
    """
       Prüft, ob der String in einen Integer oder Float umgewandelt werden kann.
    """
    try:
        if s.lower() == 'none':
            return None
        if '.' in s:
            return float(s)
        else:
            return int(s)
    except:
        return s

# *************************************************************************
class Device(object):
    
    def is_ok(self):
        """ Is the device ready to use ? """
        return False

    def ping(self):
        """ Reacts the device for a message ? """
        return False
        
    def finish(self):
        """ Helper for resetting the hardware: 
            first finish (free) resources and than reconnect to resource.
        """
        pass

    def run_persistence(self):
        """ CTRL-C handling: 
            write persistent data
        """
        pass

# *************************************************************************
class ResouceScope(object):

    """
        Implements a Context Manager for a resource.
        Used for accessing a Device using a RS232 resource.
        RS232 port will be opened if needed and closed if not needed anymore.
    """

    def __init__(self, aResource, use_exclusive=False):
        #print("INIT ResourceScope")
        self.aResource = aResource
        self.use_exclusive = use_exclusive

    def __enter__(self):
        #print("__enter__ ResourceScope")
        if not self.aResource.is_open():
            self.aResource.open()
# TODO: ggf. reset() nach open() aufrufen?            
        return self.aResource
    
    def __exit__(self, type, value, traceback):
        #print("__exit__ ResourceScope")
        self.aResource.reset()
        if self.aResource.is_open() and not self.use_exclusive:
            self.aResource.close()

# *************************************************************************
def generic_retry_on_fail(func, fcn_log, retries_on_fail=10, retry_after_seconds=5, block='Generic Retry'):
    """
    Generic retry decorator
    """

    @wraps(func)
    def wrapper(*args, **kwargs):
        succeeded = False
        retry_count = 0
        for numbers_to_retry in range(retries_on_fail, 0, -1):
            try:
                retry_count += 1
                result = func(*args, **kwargs)
                return result
            except Exception as e:
                fcn_log(f"[{block}] failed operation, as '{e}', still [{numbers_to_retry}] time(s) to retry")
                time.sleep(retry_after_seconds)
                continue
        if not succeeded:
            raise Exception(f"[{block}] failed operation after {retries_on_fail} times retried!")

    return wrapper

open_retry_repeater = lambda fcn: generic_retry_on_fail(fcn, print, 12, 5, block='RS232 open')

# *************************************************************************
class Rs232Device(Device):
    
    """
        Wrapper for pyserial RS232 object, 
        could also be used as simulation object if opening of RS232 port fails.
    """

    def __init__(self,sRs232Name,baudrate=1200,bytesize=serial.EIGHTBITS,parity=serial.PARITY_NONE,stopbits=serial.STOPBITS_ONE,timeout=None):  #19200
        super(Rs232Device,self).__init__()
        self.flushInput = lambda : self.try_func(self._flushInput)   
        self.flushOutput = lambda : self.try_func(self._flushOutput)   
        self.reset = lambda : self.try_func(self._reset)   
        self.read = lambda v : self.try_func(self._read,v)   
        self.readline = lambda : self.try_func(self._readline)   
        self.write = lambda v : self.try_func(self._write,v)   
        self.sRs232Name = sRs232Name
        self.aRs232 = serial.Serial(sRs232Name,baudrate,bytesize,parity,stopbits,timeout)
        append_to_logfile("CONSTRUCTOR Rs232Device() "+str(sRs232Name)+" "+str(self),is_debug())
#            self.reset()
            
    # WARNING: DO NOT USE __del__, because it disturbs the garbage collector while freeing resources ! see python documentation
    #def __del__(self):
    #    print "__DEL__","open=","None" if self.aRs232==None else self.aRs232.isOpen(),self,self.aRs232
    #    append_to_logfile("!!! DESTRUCTOR Rs232Device() "+str(self.sRs232Name)+" "+str(self),is_debug())
    #    if self.aRs232:
    #        self.aRs232.close()
    #    self.aRs232 = None

    def try_func(self,fcn,*args):
        try:
            return fcn(*args)
        except Exception as e:     # serial.SerialException
            append_to_logfile(str(datetime.datetime.now())+": Exception (0) in try_func(): "+str(e)+" for function: "+str(fcn)+" args: "+str(args),is_debug())
            try:
# TODO: dieses kann u.U. zu endlosen rekursionen fuehren, wenn die reconnect() immer fehlschlaegt !                
                self.reconnect()  # ==> self.reset() ==> self.try_func()
            except Exception as e2:
                append_to_logfile(str(datetime.datetime.now())+": Exception (1) in try_func(): "+str(e2),is_debug())
                try:
                    self.search_renamed_port() 
                except Exception as e3:
                    append_to_logfile(str(datetime.datetime.now())+": Exception (2) in try_func(): "+str(e3),is_debug())
                    # if this following call still raises an exception 
                    # we must reconntect both rs232 devices again, because
                    # most probably we have two new usb-rs232 device names !
                    self.check_all_ports()
            return fcn(*args)

    def reopen(self):
        try:
            #print("reopen")
            self.reconnect()  
        except Exception as e2:
            append_to_logfile(str(datetime.datetime.now())+": Exception (1) in reopen(): "+str(e2),is_debug())
            try:
                self.search_renamed_port() 
            except Exception as e3:
                append_to_logfile(str(datetime.datetime.now())+": Exception (2) in reopen(): "+str(e3),is_debug())
                # if this following call still raises an exception 
                # we must reconntect both rs232 devices again, because
                # most probably we have two new usb-rs232 device names !
                self.check_all_ports()

    def _reopen(self,lstUsbRs232Devices):
        #print("_reopen")
        sOldRs232Name = self.sRs232Name
        for sNewPortName in lstUsbRs232Devices:
            self.close()
            time.sleep(3.0)
            self.setPort(sNewPortName)
            self.open()
            if self.is_open():
                # check if this device is the expected device (== same type as before reconnect())
                if self.ping():
                    # update global data !
                    update_mapped_usb_rs232_device(sOldRs232Name,sNewPortName)
                    return True
        return False    

    def check_all_ports(self):
        """
            Check all existing serial ports for my original device,
            used after a reset of the USB Hub
        """
        append_to_logfile("CHECK_ALL_PORTS "+str(self.sRs232Name)+" "+str(self),is_debug())
        if not self._reopen(find_all_usb_rs232_devices()):
            raise Exception("Device is not the expected device (2) !")

    def search_renamed_port(self):
        """
            Try to find another serial port which might be the old one.
            Could be called if a USB error occured and the hub is reset.
        """
        append_to_logfile("SEARCH_RENAMED_PORT "+str(self.sRs232Name)+" "+str(self),is_debug())
        if not self._reopen(get_new_not_used_usb_rs232_devices(self.sRs232Name)):
            raise Exception("Device is not the expected device (1) !")
        
    def reconnect(self):
        """
            Reconnect with serial port
        """
        self.reset()
        append_to_logfile(str(datetime.datetime.now())+": RECONNECT "+str(self.sRs232Name)+" "+str(self),is_debug())
        if not self._reopen([self.sRs232Name]):
            raise Exception("Device is not the expected device (0) !")
        self.reset()
        
    def finish(self):
        #print "FINISH RS232 Device",self,self.aRs232
        #print("FINSIH")
        self.close()
        self.aRs232 = None
        
    def close(self):
        if self.aRs232:
            #print("close")
            self.aRs232.close()

    @open_retry_repeater
    def open(self):
        if self.aRs232:
            #print("open")
            self.aRs232.open()

    def is_open(self):
        if self.aRs232:
            #print("is_open")
            return self.aRs232.is_open
        return False

    def setPort(self,sPort):
        if self.aRs232:
            #print("setport",sPort)
            self.aRs232.setPort(sPort)

    def _flushInput(self):
        if self.aRs232:
            #print("flushInput")
            self.aRs232.reset_input_buffer()
               
    def _flushOutput(self):
        if self.aRs232:
            #print("flushOutput")
            self.aRs232.reset_output_buffer()

    def _reset(self):
        if self.aRs232:
            #print("reset")
# TODO -> close self.aRs232 and open it again ?            
            self.aRs232.reset_input_buffer()
            self.aRs232.reset_output_buffer()
            
    def _read(self,iSize):
        if self.aRs232:
            #print("read",iSize)
            ret = self.aRs232.read(iSize)
            return ret
        else:
            return ""

    def _readline(self):
        if self.aRs232:            
            try:
                #print("readline")
                ret = ""    
                ret = self.aRs232.readline()
                if isinstance(ret, bytes):
                    return ret.decode("utf-8") #, errors='ignore')
                return ret
            except UnicodeDecodeError as unierr:
                ret = ret.decode("utf-8", errors='ignore')
                # log is new since 4.2023 !
                append_to_logfile(str(datetime.datetime.now())+": INFO in _readline(0): "+str(unierr)+" read="+str(ret),is_debug())
# TODO -> Synchronisiere Zustand zwischen Heizungsregelung und Heizungsplatine !!! -> siehe Problem vom 19.1.2024 -> HeatingControlBoard.update_status()
                return ret
            except Exception as ex:
                # log is new since 4.2023 !
                append_to_logfile(str(datetime.datetime.now())+": EXCEPTION in _readline(1): "+str(ex)+" read="+str(ret.decode("utf-8", errors='ignore')),is_debug())
                return ""
        else:
            return ""

    def _write(self,sData):
        """
            returns number of writen bytes
        """
        if self.aRs232:
            #print("write")
            return self.aRs232.write(bytes(sData, "utf-8"))
        else:
            return 0

    def is_ok(self):
        return self.aRs232!=None           

# *************************************************************************

def do_three_switch(iChannelOpen,iChannelClose,iValue,fcn_switch_port):
    iValue = int(iValue)
    if iValue==-1:  # == Stop
        fcn_switch_port(iChannelOpen,False)
        fcn_switch_port(iChannelClose,False)
    elif iValue==0: # == Close
        fcn_switch_port(iChannelOpen,False)
        fcn_switch_port(iChannelClose,True)
    elif iValue==1: # == Open
        fcn_switch_port(iChannelClose,False)            
        fcn_switch_port(iChannelOpen,True)
    # new since 3.10.2010: handle Mixer Ticks/Pulses for tests
    elif iValue==2: # == Open-Tick / Pulse
        fcn_switch_port(iChannelClose,False)            
        fcn_switch_port(iChannelOpen,True)
        time.sleep(1.0)                # wait a moment
        fcn_switch_port(iChannelOpen,False)
    elif iValue==3: # == Close-Tick / Pulse
        fcn_switch_port(iChannelOpen,False)
        fcn_switch_port(iChannelClose,True)
        time.sleep(1.0)                # wait a moment
        fcn_switch_port(iChannelClose,False)

# *************************************************************************
class HeatingControlBoard(Rs232Device):
    
    def __init__(self,sRs232Name,baudrate=19200,bytesize=serial.EIGHTBITS,parity=serial.PARITY_NONE,stopbits=serial.STOPBITS_ONE,timeout=None):
        super(HeatingControlBoard,self).__init__(sRs232Name,baudrate,bytesize,parity,stopbits,timeout)
        append_to_logfile("CONSTRUCTOR HeatingControlBoard() "+str(sRs232Name)+" "+str(self),is_debug())
        self.cache = [None for i in range(16)]

    def ping(self):
        with ResouceScope(self,g_bExclusiveRs232) as device:
            iCount = device.write("PING;")
            sData = device.readline()
            return sData.startswith("PONG;")        
        
    def read_temperatures(self):
        with ResouceScope(self,g_bExclusiveRs232) as device:
            device.write("READ_TEMP;")
            return device.readline()

    def _check_hardware_status_with_cache(self,sStatus):
        # process something like: Rel1=0;Rel2=1;Rel3=1;...;Rel12=0;
        aStatusParts = sStatus.strip().split(";")
        needed_updates = [] # list of (channel, value) tuples
        for sPart in aStatusParts:
            if sPart.startswith("Rel"):
                aKeyValue = sPart.split("=")
                if len(aKeyValue)==2:
                    iChannel = int(aKeyValue[0][3:])-1   # REMARK: Hardware/firmware index=1..12 <==> python control program logical index=0..11  
                    bHwValue = aKeyValue[1]=="1"
                    if iChannel>=0 and iChannel<len(self.cache):
                        if (self.cache[iChannel]!=None) and (self.cache[iChannel]!=bHwValue):
                            # cache value differs from hardware value (most probably reset of heizungsplatine?) -> update hardware
                            needed_updates.append( (iChannel,self.cache[iChannel]) )
        return needed_updates
    
    def update_status(self):
        with ResouceScope(self,g_bExclusiveRs232) as device:
            device.write("READ_RELAIS;")
            result = device.readline()
# TODO -> 29.1.2026 -> der Cache Mechanismus funktioniert nicht richtig, wenn die Heizungsplatine zurueckgesetzt wird (Reset) ! Z. B. wegen Firmware/Software Fehler -> falls Cache nicht mit Hardware Status uebereinstimmt, dann Hardware aktualisieren !
            # if read-status != current-status -> write current-status to board
            needed_updates = self._check_hardware_status_with_cache(result)
            if len(needed_updates)>0:
                append_to_logfile("HeatingControlBoard.update_status(): updating board status, needed updates: "+str(needed_updates),is_debug())
                for (iChannel,bValue) in needed_updates:
                    self._switch_port_advanced(iChannel,bValue,bForceWrite=True)
            return 0

    def three_switch_port_fcn(self,iChannelOpen,iChannelClose):
        return functools.partial(self._three_switch,iChannelOpen,iChannelClose)
        
    def switch_port_fcn(self,iChannel):
        return functools.partial(self._switch_port,iChannel)
        
    def switch_port_for_not_value_fcn(self,iChannel):
        return functools.partial(self._switch_port_for_not_value,iChannel)
        
    def switch_virtual_port_fcn(self,iVirtualChannel):
        return functools.partial(self._switch_virtual_port,iVirtualChannel)
        
    def _three_switch(self,iChannelOpen,iChannelClose,iValue):
        do_three_switch(iChannelOpen,iChannelClose,iValue,self._switch_port)

    def _switch_port(self,iChannel,bValue):
        return self._switch_port_advanced(iChannel,bValue,bForceWrite=False)

    def _switch_port_advanced(self,iChannel,bValue,bForceWrite=False):
        #print "_switch_port",iChannel,bValue
        sValue = "1" if bValue else "0"
        # write something like: SET_RELAIS:rel1=1;
        # REMARK: Hardware/firmware index=1..12 <==> python control program logical index=0..11  
        bWriteToHardware = bForceWrite or (self.cache[iChannel] != bValue)
        if bWriteToHardware:
            self.cache[iChannel] = bValue
            with ResouceScope(self,g_bExclusiveRs232) as device:
                device.write("SET_RELAIS:rel"+str(iChannel+1)+"="+sValue+";")
                return device.readline()     
        else:
            # simulate original response
            return "OK:Rel"+str(iChannel)+"="+str(int(bValue))+"\n"
            
    def _switch_port_for_not_value(self,iChannel,bValue):
        self._switch_port(iChannel,not bValue)
        
    def _switch_virtual_port(self,iVirtualChannel,bValue):
        # simulate original response
        return "OK:Rel"+str(iVirtualChannel)+"="+str(int(bValue))+"\n"

# *************************************************************************
class ArduinoMega(Rs232Device):
    
    def __init__(self,sRs232Name,baudrate=19200,bytesize=serial.EIGHTBITS,parity=serial.PARITY_NONE,stopbits=serial.STOPBITS_ONE,timeout=None):
        super(ArduinoMega,self).__init__(sRs232Name,baudrate,bytesize,parity,stopbits,timeout)
        append_to_logfile("CONSTRUCTOR ArduinoMega() "+str(sRs232Name)+" "+str(self),is_debug())
        if self.is_ok():
            # after connecting with arduino via RS232 a reset of the arduino occures
            # give it a litle bit time for start of communication !
            time.sleep(3)
            #self.ping()
        #print "INIT Arduino",self,sRs232Name

    def read_temperatures(self):
        with ResouceScope(self,g_bExclusiveRs232) as device:
            device.write("READ_TEMP;")
            return device.readline()

    def ping(self):
        with ResouceScope(self,g_bExclusiveRs232) as device:
            iCount = device.write("PING;")
            sData = device.readline()
            return sData.startswith("PONG;")

# *************************************************************************
class ConradMultiRelais(Rs232Device):
    
    MIXER_TICK_TIME = 1.0   # until 7.11.2012: 3.0       # pulse time in seconds
    
    def __init__(self,sRs232Name,baudrate=19200,bytesize=serial.EIGHTBITS,parity=serial.PARITY_NONE,stopbits=serial.STOPBITS_ONE,timeout=None):
        super(ConradMultiRelais,self).__init__(sRs232Name,baudrate,bytesize,parity,stopbits,timeout)
        append_to_logfile("CONSTRUCTOR ConradMultiRelais() "+str(sRs232Name)+" "+str(self),is_debug())
        self.aActValues = None
        self.iErrorCount = 0
        self._initialize()
        self.update_status()
        #print "INIT ConradRelais",self,sRs232Name
        
    def ping(self):
        ret = self._write_message(0,0,0)
        if ret!=None and len(ret)>3:
            return ord(ret[0])==255 and ord(ret[1])==0 and ord(ret[2])==0
        return False

    def update_status(self):
        aActValues,iLenMsg = self._get_ports()
        if aActValues!=None:
            self.aActValues = aActValues
            self.iErrorCount = 0
        else:
            append_to_logfile("ERROR in relais.update_status() len="+str(iLenMsg)+" "+str(datetime.datetime.now()),is_debug())
            self.iErrorCount += 1
            if self.iErrorCount>5:      # until 26.10.2010 n=10, now n=5
                raise Exception("Error in update_status --> can not read port status !")
        return self.aActValues

    def three_switch_port_fcn(self,iChannelOpen,iChannelClose):
        return functools.partial(self._three_switch,iChannelOpen,iChannelClose)
        
    def switch_port_fcn(self,iChannel):
        return functools.partial(self._switch_port,iChannel)
        
    def switch_port_for_not_value_fcn(self,iChannel):
        return functools.partial(self._switch_port_for_not_value,iChannel)
        
    def switch_virtual_port_fcn(self,iVirtualChannel):
        return functools.partial(self._switch_virtual_port,iVirtualChannel)

    def _three_switch(self,iChannelOpen,iChannelClose,iValue):
        do_three_switch(iChannelOpen,iChannelClose,iValue,self._switch_port)
                
    def _switch_port(self,iChannel,bValue):
#(TODO --> ggf. nur senden falls sich zustand aendert ! ... ==> wohl nicht mehr notwendig seit dem die Probleme mit RS232/USB geloest sind --> durch UART verwenden
        ret = self._write_message(6 if bValue else 7,0,(1 << iChannel))
# TODO --> check result ? --> ret[2] == ports
        return True
        
    def _switch_port_for_not_value(self,iChannel,bValue):
        self._switch_port(iChannel,not bValue)
        
    def _switch_virtual_port(self,iVirtualChannel,bValue):
        # simulate original response
        return True

    def _get_ports(self):
        data = self._write_message(2,0,0)
        if data!=None and len(data)>2:
            return (int(ord(data[2])),len(data))
        return (None,-1 if data==None else len(data)) 
        
    def _initialize(self):
        ret = self._write_message(1,0,0)
# TODO --> check result ? --> ret[2] == firmware version == 11
        return True
        
    def _create_message(self,iByte0,iByte1,iByte2):
        iByte3 = iByte0 ^ iByte1 ^ iByte2
        return chr(iByte0)+chr(iByte1)+chr(iByte2)+chr(iByte3)
        
    def _write_message(self,iByte0,iByte1,iByte2):
        if self.aRs232:
            self.flushOutput()
            self.flushInput()
            #self.reset()
            count = self.write(self._create_message(iByte0,iByte1,iByte2))
            data = self.read(8)
            return data
        return None
        
# *************************************************************************
class ControlEngine(list):
    
    DELAY = 5.0         # old: 2.0 seconds between ticks 
    
    def run(self,sFileName,thread_communication_context,aLock):
        self._initialize()
        self.iCount = 0
        self.bStop = False
        self.aDataNodes = self._get_data_nodes()
        self.aMQTTClient = mqtt.Client()
        self.aMQTTClient.on_connect = self.on_mqtt_connect
        self.aMQTTClient.on_disconnect = self.on_mqtt_disconnect
        self.aMQTTClient.on_message = self.on_mqtt_message
        self.aMQTTClient.loop_start()
        self.aPublishIfChangedCache = {}
        #for debugging -> connect without thread
        #ok = self.aMQTTClient.connect(IP_OF_MQTT_BROKER, 1883, 60)
        #print(ok)
        threading.Thread(target=self.reconnect_mqtt, daemon=True).start()
        thread_communication_context['fcn_set_stop'] = self._set_stop
        thread_communication_context['fcn_poll_for_commands'] = self._poll_for_commands
        return self._run(sFileName,aLock)
    
    def reconnect_mqtt(self):
        while True:
            if is_debug():
                print("############################################")
                print("Connect with MQTT Broker Thread", datetime.datetime.now(), self.aMQTTClient.is_connected(), self.aMQTTClient)
                print("############################################")
            if not self.aMQTTClient.is_connected():
                try:
                    if is_debug():
                        print("############################################")
                        print("🔄 Try to connect...")
                        print("############################################")
                    self.aMQTTClient.connect(IP_OF_MQTT_BROKER, 1883, keepalive=60)  # TODO -> localhost on Raspberry Pi !!!
                    if is_debug():
                        print("SUCCESS:", self.aMQTTClient.is_connected())
                        print("############################################")
                except Exception as e:
                    print("############################################")
                    print(f"########### Broker not reachable: {e}")
                    print("############################################")
            else:
                if is_debug():
                    print("############################################")
                    print("✅ Already connected with MQTT-Broker")
                    print("############################################")
            time.sleep(60)

    def on_mqtt_connect(self,client, userdata, flags, rc):
        print("############################################")
        print("*** Connected with result code "+str(rc))
        print("############################################")
        # Subscribing in on_connect() means that if we lose the connection and
        # reconnect then subscriptions will be renewed.
        #client.subscribe("heating/control/#")
        # Subscribe to manual switch updates
        client.subscribe("heating/manual_switch/#")
        # client.subscribe("heating/manual_switch/manual_switch_motor_solar")
        # client.subscribe("heating/manual_switch/manual_switch_motor_heating")
        # client.subscribe("heating/manual_switch/manual_switch_heating_only_night")
        # client.subscribe("heating/manual_switch/manual_switch_heating_date")
        # client.subscribe("heating/manual_switch/manual_switch_max_temp_control")
        # client.subscribe("heating/manual_switch/manual_switch_mixer_heating")
        # client.subscribe("heating/manual_switch/manual_switch_heatpump")
        # client.subscribe("heating/manual_switch/manual_switch_ventilation")
        # client.subscribe("heating/manual_switch/manual_switch_heatpump_solar_valve")
        # client.subscribe("heating/manual_switch/manual_switch_booster")
        # client.subscribe("heating/manual_switch/manual_switch_heatpump_only_with_pv")
        # Subscribe to history requests
        client.subscribe("heating/history/request")
        #client.subscribe("heating/history/request/#")
        # client.subscribe("heating/history/request/HEAT_CREATOR")
        # client.subscribe("heating/history/request/SOLAR_KVLF")
        # client.subscribe("heating/history/request/SOLAR_SLVF")
        # client.subscribe("heating/history/request/WARM_WATER")
        # client.subscribe("heating/history/request/BUFFER1")
        # client.subscribe("heating/history/request/BUFFER2")
        # client.subscribe("heating/history/request/OUTDOOR")
        # client.subscribe("heating/history/request/OUTGOING_AIR")
        # client.subscribe("heating/history/request/CONVERTER")
        # client.subscribe("heating/history/request/MIXER_HEATING")
        # client.subscribe("heating/history/request/ROOM")

    def on_mqtt_disconnect(self,client, userdata, rc):
        print("############################################")
        print("*** Disconnected with result code "+str(rc))
        print("############################################")

    def on_mqtt_message(self,client, userdata, msg):
        if is_debug():
            print("*** "+msg.topic+" "+str(msg.payload))
        # TODO -> process incoming MQTT messages here !!!
        # e.g. set new manual switch values     -> self._update_data_for_data_nodes(data_read)
        # get plot data for temperature nodes   -> self._get_history_for_data_node(data_read)
        # etc.

        # update manual switch values
        if msg.topic.startswith("heating/manual_switch/"):
            switch_name = msg.topic[len("heating/manual_switch/"):]
            try:
                iValue = check_type(msg.payload.decode("utf-8"))
                data_read = { switch_name.upper() : iValue }
                _num_updated, _num_total = self._update_data_for_data_nodes(data_read)
                if is_debug():
                    print(f"### Updated {_num_updated} of {_num_total} data nodes from MQTT message", data_read)
            except Exception as e:
                print(f"### ERROR processing MQTT message for topic {msg.topic}: {e}")
        # process history requests
        # Browser-Client  -> /heating/history/request/ROOM          subscribe
        #                             ^                                 v
        # Heizungs-Client ->       subscribe                  /heating/history/response/ROOM
        # elif msg.topic.startswith("heating/history/request/"):
        #     node_name = msg.topic[len("heating/history/request/"):]
        #     try:
        #         args = { 'name': node_name.upper() }
        #         history_data = self._get_history_for_data_node(args)
        #         # publish history data to response topic
        #         response_topic = f"heating/history/response/{node_name}"
        #         payload = json.dumps(history_data)
        #         self.aMQTTClient.publish(response_topic, payload)
        #         if is_debug():
        #             print(f"### Published history data for node {node_name} to topic {response_topic}")
        #     except Exception as e:
        #         print(f"### ERROR processing MQTT history request for topic {msg.topic}: {e}")        
        elif msg.topic == "heating/history/request":    # after receiving request from clinent, send response to clinent
            try:
                args = { 'name': 'TIMELINE' }
                timeline_data = self._get_history_for_data_node(args)
                timeline_data = [e.isoformat() for e in timeline_data]  # convert datetime objects to ISO strings for JSON serialization

                signals_data = []
                payload_str = msg.payload.decode("utf-8")
                lst_signal_names = json.loads(payload_str)
                import simplesrv
                aColorMapping = simplesrv.get_all_colors_for_name()
                for signal_name in lst_signal_names:
                    args = { 'name': signal_name.upper() }
                    history_data = self._get_history_for_data_node(args)
                    signals_data.append((signal_name, simplesrv.get_temperature_color_tuple(signal_name, aColorMapping)[1], history_data))

                data_out = (timeline_data, signals_data)

                # publish history data to response topic
                response_topic = "heating/history/response"
                payload = json.dumps(data_out)
                self.aMQTTClient.publish(response_topic, payload)
                if is_debug():
                    print(f"### Published history data to topic {response_topic}")
            except Exception as e:
                print(f"### ERROR processing MQTT history request for topic {msg.topic}: {e}")

    def _set_stop(self,value):
        self.bStop = value
        
    def finish(self):
        # delegate finish-call to all children
        for e in self:
            e.finish()

    def get_graph(self):
        sGraph = ""
        for signal_processor in self:
            if len(sGraph)>0:
                sGraph += "\n"
            sGraph += signal_processor.get_graph()
        return sGraph
    
    def get_dot_data(self):
        """
            Return data which can be used with graphviz (.dot)
        """
        sGraph = ""
        for signal_processor in self:
            #if len(sGraph)>0:
            #    sGraph += "\n"
            sGraph += signal_processor.get_dot_data()
        return sGraph

    def run_persistence(self):
        # delegate finish-call to all children
        for e in self:
            e.run_persistence()
        
    def _get_data_nodes(self):
        aData = {}
        for e in self:
            #if isinstance(e,TemperatureSource) or isinstance(e,SwitchRelais):
            aData[e.get_name()] = e
        return aData    

    def _get_act_data_from_data_nodes(self,iCount,bWithStdDev=False):
        aActData = {}
        aActData["ACT_TICK"] = iCount
        aActData["MASTER_ID"] = self.sMasterId
        for e in self.aDataNodes:
            if bWithStdDev:
                aActData[self.aDataNodes[e].get_name()] = (self.aDataNodes[e].get_value(), self.aDataNodes[e].get_stddev_value())
            else:
                aActData[self.aDataNodes[e].get_name()] = self.aDataNodes[e].get_value()
            # return additional data for the node, i. e. constants
            aAdditionalData = self.aDataNodes[e].get_additional_data_items()
            if aAdditionalData!=None:
                for key in aAdditionalData:
                    aActData[key] = aAdditionalData[key]
        return aActData
        
    def _get_history_for_data_node(self,args):
        if 'name' in args:
            sNodeName = args['name']
            if sNodeName in self.aDataNodes:
                return self.aDataNodes[sNodeName].get_history()
        return []
        
    def _update_data_for_data_nodes(self,aNewData):
        """
            Convert { "KEY" : value } into obj.get_name()=="KEY" --> obj.set_value(value)
        """
        iCount = 0
        for key in aNewData:
            # special handling for master_id --> is handled by the control engine object !
            if key=="MASTER_ID":
                self.sMasterId = aNewData[key]
            else:
                for e in self:
                    if key==e.get_name():
                        if e.get_value() != aNewData[key]:
                            e.set_value(aNewData[key])
                            iCount += 1
        return (iCount,len(aNewData))

    def _poll_server_cmd_queue(self,qWrite,qRead,iCount):
        bContinueProcessing = False
        if not qRead.empty():
            data = qRead.get().upper()
            #print( "################################## ",data )
            if data=="STOP":
                return True,False #bContinueProcessing
            elif data=="EXCEPTION":
                raise Exception("Software Exception")
            elif data=="READ":
                _vals = self._get_act_data_from_data_nodes(iCount)
                # _vals = {'ACT_TICK': 19, 'MASTER_ID': 'None', 'TEMP_MEAS': None, 'LIGHT1': 5.32, 'LIGHT2': 23.23, 'SOLAR_KVLF': 25.46, 'SOLAR_SLVF': 65.66, 'OUTDOOR': 7.12, 'MIXER_HEATING': 28.86, 'BUFFER1': 41.27, 'BUFFER2': 38.59, 'OUTGOING_AIR': 14.96, 'WARM_WATER': 81.04, 'HEAT_CREATOR': 20.68, 'CONVERTER': 5.32, 'ROOM': 23.23, 'SOLAR_CONTROL': 0, 'HEATING_CONTROL': 1, 'HEATING_CONTROL_SWITCH_ON_TEMP': 10.0, 'MIXER_HEATING_DES': 24.5, 'MIXER_HEATING_DES_CURRENT_DESIRED_TEMPERATURE': 24.5, 'MIXER_HEATING_DES_CURRENT_MAX_TEMPERATURE': 28.0, 'MIXER_HEATING_CONTROL': -1, 'HEATPUMP_CONTROL': None, 'HEATPUMP_CONTROL_SWITCH_ON_TEMP': 37.5, 'HEATPUMP_CONTROL_SWITCH_OFF_TEMP': 41.0, 'HEATPUMP_CONTROL_SWITCH_OFF_AIR_TEMP': -0.5, 'VENTILATION_CONTROL': 0, 'HEATPUMP_SOLAR_VALVE_CONTROL': 0, 'ENABLE_HEATING_MOTOR': 0, 'ENABLE_HEATING_MOTOR_INTERVALS': 'start=08:00:00 stop=14:00:00 [0, 1, 2, 3, 4],<br>start=09:00:00 stop=17:00:00 [5, 6],<br>start=21:00:00 stop=23:59:59.999999 ,<br>start=00:00:00 stop=03:00:00 ,<br>', 'ENABLE_HEATING_MOTOR_NIGHT': 0, 'ENABLE_HEATING_MOTOR_NIGHT_INTERVALS': 'start=21:00:00 stop=23:59:59.999999 ,<br>start=00:00:00 stop=03:00:00 ,<br>', 'ENABLE_HEAT_PUMP': None, 'ENABLE_MIXER_CLOSE': 0, 'ENABLE_MIXER_CLOSE_INTERVALS': 'start=14:02:00 stop=14:04:30 [0, 1, 2, 3, 4],<br>start=17:02:00 stop=17:04:30 [5, 6],<br>start=03:02:00 stop=03:04:30 ,<br>', 'ENABLE_DATE_HEATING_MOTOR': 1, 'ENABLE_DATE_HEATING_MOTOR_INTERVALS': 'start=2024-11-01 stop=2025-03-15 ,<br>start=2025-11-01 stop=2026-03-15 ,<br>', 'ENABLE_ANTI_FIXING_SWITCH': None, 'ENABLE_ANTI_FIXING_SWITCH_INTERVALS': 'start=22:30:00 stop=22:35:00 ,<br>', 'MANUAL_SWITCH_MOTOR_SOLAR': '1', 'MANUAL_SWITCH_MOTOR_HEATING': '1', 'MANUAL_SWITCH_HEATING_ONLY_NIGHT': None, 'MANUAL_SWITCH_HEATING_DATE': None, 'NOT_MANUAL_SWITCH_HEATING_DATE': None, 'ENABLE_HEATING_MOTOR_VALUE': 0, 'ENABLE_HEATING_MOTOR_DATE': 1, 'ENABLE_HEATING_MOTOR_DATE_AND_VALUE': 0, 'ENABLE_HEATING_MOTOR_ALL_INPUTS': 1, 'MANUAL_SWITCH_MAX_TEMP_CONTROL': None, 'ENABLE_MIXER_MAX_TEMP_CONTROL': None, 'MANUAL_SWITCH_MIXER_HEATING': None, 'MANUAL_SWITCH_HEATPUMP': None, 'MANUAL_SWITCH_VENTILATION': None, 'MANUAL_SWITCH_HEATPUMP_SOLAR_VALVE': None, 'MANUAL_SWITCH_BOOSTER': None, 'SWITCH_MOTOR_SOLAR': 1, 'SWITCH_MOTOR_HEATING': 1, 'SWITCH_MIXER_HEATING': -1, 'SWITCH_MIXER_HEATING_CURRENT_OPEN_COUNT': -29, 'ENABLE_MIXER_MOVEMENT': 1, 'SWITCH_HEATPUMP': 0, 'SWITCH_VENTILATION': 0, 'SWITCH_HEATPUMP_SOLAR_VALVE': 0, 'SWITCH_BOOSTER': 0, 'INGOING_AIR': -71.0, 'TIMELINE': datetime.datetime(2025, 12, 12, 17, 22, 43, 762852), 'RELAIS_MEAS': None, 'TICK_COUNTER': 1, 'ARDURINO_COUNT': 28.86, 'TESTSENSOR_PT1000': 28.86, 'OPERATING_HOURS_HEATPUMP': (12955.374925700016, [798965.0, 998965.0]), 'OPERATING_HOURS_MOTOR_HEATING': (18311.026037899996, [798965.0, 998965.0]), 'OPERATING_HOURS_MOTOR_SOLAR': (12418.560111400002, [798965.0, 998965.0]), 'MANUAL_SWITCH_HEATPUMP_ONLY_WITH_PV': '0', 'LOGIC_IS_MANUAL_SWITCH_HEATPUMP_ONLY_WITH_PV': 0, 'LOGIC_IS_NOT_MANUAL_SWITCH_HEATPUMP_ONLY_WITH_PV': 1, 'ENABLE_HEAT_PUMP_FOR_PV': 0, 'ENABLE_HEAT_PUMP_FOR_PV_INTERVALS': 'start=10:00:00 stop=15:59:59.999999 ,<br>', 'LOGIC_ENABLE_HEATPUMP_VIA_PV': 0, 'ESP32_HTTP_TEMP': -1.0}
                qWrite.put(_vals)
            elif data=="READ_EXTENDED":
                qWrite.put(self._get_act_data_from_data_nodes(iCount,bWithStdDev=True))
            elif data=="WRITE":
                data_read = qRead.get()
                # something like: /write?MANUAL_SWITCH_MOTOR_SOLAR=1
                #print("==================************** write --> ",data_read)
                qWrite.put(self._update_data_for_data_nodes(data_read))
                bContinueProcessing = True    # if we get a write operation --> continue immediately with processing (switch relais)
            elif data=="HISTORY":
                data_read = qRead.get()
                qWrite.put(self._get_history_for_data_node(data_read))
            elif data=="VERSION":
                qWrite.put("Controll Process Version: "+__version__+" from "+__date__)
            else:
                qWrite.put("ERROR: unknown pipe command "+str(data))
        return False,bContinueProcessing

    def _poll_socket_cmd_queue(self,qWrite,qRead,iCount):
        # currently the same implementation as for http server...
        return self._poll_server_cmd_queue(qWrite,qRead,iCount)

    def _wait_and_poll_cmd_queues(self,aDelay,qWrite,qRead,qSocketWrite,qSocketRead,iCount):
        aStartTime = time.time()
        # new since 3.10.2010: stop polling loop and process command if write command is received, see _poll_server_cmd_queue()
        bContinueProcessing = False
        while time.time()-aStartTime<aDelay and not bContinueProcessing:
            #DEBUG: print self._get_act_data_from_data_nodes(iCount)
            # check for queue commands
            #print("poll srv")
            bStop,bContinueProcessing = self._poll_server_cmd_queue(qWrite,qRead,iCount)
            if bStop:
                return True
            # check for socket commands      
            #print("poll socket")
            bStop,bContinueProcessing = self._poll_socket_cmd_queue(qSocketWrite,qSocketRead,iCount)
            if bStop:
                return True
            time.sleep(0.1)
        return False

    def _poll_for_commands(self,qWrite,qRead,qSocketWrite,qSocketRead):
        bContinueProcessing = False
        bStop = False
        bStop,bContinueProcessing = self._poll_server_cmd_queue(qWrite,qRead,self.iCount)
        if bStop:
            return bStop
        bStop,bContinueProcessing = self._poll_socket_cmd_queue(qSocketWrite,qSocketRead,self.iCount)
        return bStop
        
    def _wait(self,aDelay):
        time.sleep(aDelay)
        return False

    def _initialize(self):
        self.sMasterId = "None"
        self._sort_list()
        for e in self:
            e.clock_init()
            
    def _run(self,sFileName,aLock):
        # write description for columns in header line
        aDataHeader = ["tick_no","date","time"]
        for e in self:
            aDataHeader.append(e.get_name())
        indizes_for_temperatures = get_indizes_for_all_names(MQTT_TEMPERATURE_NAMES, aDataHeader)
        indizes_for_manual_switches = get_indizes_for_all_names(MQTT_MANUAL_SWITCH_NAMES, aDataHeader)
        indizes_for_switches = get_indizes_for_all_names(MQTT_SWITCH_NAMES, aDataHeader)
        indizes_for_controls = get_indizes_for_all_names(MQTT_CONTROL_NAMES, aDataHeader)
        indizes_for_operating_hours = get_indizes_for_all_names(MQTT_OPERATING_HOURS_NAMES, aDataHeader)
        indizes_for_intervals = get_indizes_for_all_names(MQTT_INTERVAL_NAMES, aDataHeader)

        sActFileName,aActDate,bNewFile = map_date_to_filename(sFileName,is_debug(),None)
        append_to_file(sActFileName,aDataHeader,sPrefix="#")
        # process the system (endless)
        iCount = get_last_count_from_file(sActFileName)
        bStop = False
        
        while not bStop:
            if is_debug():
                print( "===================================================" )
                print( "TICK",iCount,"TIME",float(iCount)*float(self.DELAY) )
                print( "TICK MASTER_ID value=",self.sMasterId )
            if iCount % 12 == 0:
                # print every minute the timestamp to the consoloe (for debugging)
                print( "ALIVE:", str(datetime.datetime.now()), "; ", end='')
            # Bugfix 12.10.2010: get actual date/time object for determining time/date for output and output file
            # get actual date for next output of data
            sActFileName,aActDate,bNewFile = map_date_to_filename(sFileName,is_debug(),aActDate)
            # prepare item for single step/measurement output
            aLineInfo = [iCount,"%02d.%02d.%04d" % (aActDate.day,aActDate.month,aActDate.year), "%02d:%02d:%02d" % (aActDate.hour,aActDate.minute,aActDate.second)]
            aLineInfoExtended = [None, None, None]
            with aLock:
                self.iCount = iCount
                bStop = self.bStop
                for e in self:
                    #try:
                    #if True:
                    val = e._do_clock_tick()
# TODO hier ggf. nicht alle Exceptions fangen, damit ein neustart der Anwendung bei ausfall der Hardware erfolgen kann...                    
                    #except Exception,aException:
                    #    print aException
                    #    sActFileName,aActDate,bNewFile = map_date_to_filename(sFileName,is_debug(),aActDate)
                    #    append_to_file(sActFileName,[str(aException)],sPrefix="#") # log exception as comment line
                    #    val = None
                    _val_for_csv_file = val
                    _val_extended = None
                    # Improvement 23.1.2024:
                    # if the value is a container, just use the first element of the container to write into the csv file,
                    # the rest of the content in the container are calculated data used for viewers
                    # i. e. OperatingHoursCounter returns (counter, list(histogram_for_last_days)))
                    if isinstance(_val_for_csv_file, (list, tuple)):
                        if len(_val_for_csv_file) > 1:
                            _val_extended = _val_for_csv_file[1]
                        _val_for_csv_file = _val_for_csv_file[0] if len(_val_for_csv_file) > 0 else val
                    e._push_value(val)         # set the actual value at the SignalProcessor node (for history of signal)
                    aLineInfo.append(_val_for_csv_file)      # save the actual value for output to file
                    aLineInfoExtended.append(_val_extended)  # save the extended value (with additional data) for debugging output
            # Bugfix 20.8.2010/12.10.2010 --> first append act data into actual csv file, after that update filename with new date for next data output
            # --> fix to remove first line in csv file with old date !
            if bNewFile:
                append_to_file(sActFileName,aDataHeader,sPrefix="#")
            append_to_file(sActFileName,aLineInfo)

            # Debug output:
            #print("####>>>>", len(aDataHeader), aDataHeader)
            #print("####<<<<", len(aLineInfo), aLineInfo)

            # *** Write data to MQTT Broker ***
            topic = f"heating/tick_no"
            payload = f"{iCount}"
            result = self.aMQTTClient.publish(topic, payload, retain=True)   # qos=0,1,2  # return=MQTTMessageInfo.is_published()
            if is_debug():
                print(f"Publishing to MQTT topic: {topic} with payload: {payload}", result, result.is_published())

            temperature_values = [aLineInfo[i] for i in indizes_for_temperatures]
            for name, value in zip(MQTT_TEMPERATURE_NAMES, temperature_values):
                topic = f"heating/temperature/{name.lower()}"
                payload = f"{value}"
                # temperatures have a lot of noise -> caching and pullish only if changed does help to reduce mqtt traffic
                result = self.aMQTTClient.publish(topic, payload, retain=True)   # qos=0,1,2  # return=MQTTMessageInfo.is_published()
                if is_debug():
                    print(f"Publishing to MQTT topic: {topic} with payload: {payload}", value, type(value), result, result.is_published())

            manual_switch_values = [aLineInfo[i] for i in indizes_for_manual_switches]
            for name, value in zip(MQTT_MANUAL_SWITCH_NAMES, manual_switch_values):
                topic = f"heating/manual_switch/{name.lower()}"
                payload = f"{value}"
                result = self._publish_if_changed(topic, payload)
                if is_debug():
                    print(f"Publishing to MQTT topic: {topic} with payload: {payload}", value, type(value), result, result.is_published())

            switch_values = [aLineInfo[i] for i in indizes_for_switches]
            for name, value in zip(MQTT_SWITCH_NAMES, switch_values):
                topic = f"heating/switch/{name.lower()}"
                payload = f"{value}"
                result = self._publish_if_changed(topic, payload)
                if is_debug():
                    print(f"Publishing to MQTT topic: {topic} with payload: {payload}", value, type(value), result, result.is_published())

            control_values = [aLineInfo[i] for i in indizes_for_controls]
            for name, value in zip(MQTT_CONTROL_NAMES, control_values):
                topic = f"heating/control/{name.lower()}"
                payload = f"{value}"
                result = self._publish_if_changed(topic, payload)
                if is_debug():
                    print(f"Publishing to MQTT topic: {topic} with payload: {payload}", value, type(value), result, result.is_published())

            operating_hours_values = [[aLineInfo[i], aLineInfoExtended[i]] for i in indizes_for_operating_hours]
            for name, value in zip(MQTT_OPERATING_HOURS_NAMES, operating_hours_values):
                topic = f"heating/operating_hours/{name.lower()}"
                payload = f"{value}"
                result = self._publish_if_changed(topic, payload)
                if is_debug():
                    print(f"Publishing to MQTT topic: {topic} with payload: {payload}", value, type(value), result, result.is_published())

            interval_values = [aLineInfo[i] for i in indizes_for_intervals]
            for name, value in zip(MQTT_INTERVAL_NAMES, interval_values):
                topic = f"heating/intervals/{name.lower()}"
                payload = f"{value}"
                result = self._publish_if_changed(topic, payload)
                if is_debug():
                    print(f"Publishing to MQTT topic: {topic} with payload: {payload}", value, type(value), result, result.is_published())

            self._wait(self.DELAY)
            iCount += 1
            sys.stdout.flush() 
        return True
        
    def _publish_if_changed(self, topic, payload):
        if topic not in self.aPublishIfChangedCache or self.aPublishIfChangedCache[topic] != payload:
            result = self.aMQTTClient.publish(topic, payload, retain=True)   # qos=0,1,2  # return=MQTTMessageInfo.is_published()
            self.aPublishIfChangedCache[topic] = payload
            return result
        return None

    def _sort_list(self):
# TODO --> in die richtige Reihenfolge bringen --> gerichete Graphen ?!
        if is_debug():
            print( "WARNING: _sort_list() not implemented yet !" )
    
# *************************************************************************
class SignalProcessor(object):

    MAX_TIMELINE_ELEMENTS = 100
    
    def __init__(self,sName):
        self.sName = sName
        self.aInputSignals = {}
        self.aTimeline = []
        self.bActivated = True
        if g_bUseCache:
            sPersitencePath = add_sdcard_path_if_available(g_sCachePath)
            cacheInfo = pipeprocessing.CreateAveragedHistoryCache(sName, sPersitencePath=sPersitencePath)
            self.aHistoryCache = cacheInfo[0]
            self.fcnValueProducer = cacheInfo[1]
        else:
            self.aHistoryCache = []
            self.fcnValueProducer = None
                
    def finish(self):
        #print "FINISH",self
        pass

    def node_type(self):
        return LAYER_UNKNOWN

    def _get_input_signal(self, input_signal):
        if self.aInputSignals[input_signal] is not None:
            if isinstance(self.aInputSignals[input_signal], str):
                # functools.partial(<bound method TemperatureMeasurement.get_channel of <__main__.TemperatureMeasurement object at 0x000001E41EBDEE40>>, 0)
                return self.aInputSignals[input_signal]
            elif isinstance(self.aInputSignals[input_signal], functools.partial):
                func = self.aInputSignals[input_signal]
                #print("--->",input_signal, self.aInputSignals, input_signal)
                return f"{func.get_node_name()}"
                #return f"{dir(func.func.__func__)} {func.func.__func__} {func.func.__class__}.{func.func.__name__} {func.func.__name__}({func.args})"
            else:
                return str(self.aInputSignals[input_signal].get_name()) #+':'+self.__class__.__name__)
        return 'NO_INPUT_for_'+input_signal

    def get_graph(self):
        sInput = ""
        for input_signal in self.aInputSignals:
            if len(sInput)>0:
                sInput += ", "
            sInput += self._get_input_signal(input_signal)
        return f"{self.sName}:{self.__class__.__name__} <- [{sInput}]"

    def get_dot_data(self):
        """
            Return data which can be used with graphviz (.dot)
        """
        sInput = ""
        sShape = f'shape={_node_type_to_shape(self.node_type())}'
        sColor = f'color={_node_type_to_color(self.node_type())}'
        sInput += self.get_name() #+ '::' + str(self)
        sInput += f'[ {sShape} {sColor} ]\n'
        for input_signal in self.aInputSignals:
            sInput += self._get_input_signal(input_signal)
            sInput += ' -> '
            sInput += self.sName
            sInput += f' [label="input"]'
            sInput += "\n"
        return sInput

    def run_persistence(self):
        self.aHistoryCache.run_persistence()

    def get_name(self):
        return self.sName
        
    def get_additional_data_items(self):
        return None
        
    def is_activated(self):
        return self.bActivated
        
    def set_activated(self,bValue):
        self.bActivated = bValue
        
    def has_input(self):
        return len(self.aInputSignals)>0
        
    def connect_input(self,aSignalNode,sKey):
        self.aInputSignals[sKey] = aSignalNode
        
    def get_input(self,sKey):
        return self.aInputSignals.get(sKey,None)        
        
    def set_value(self,aNewValue):
        """
            Used for manually overriding of values.
        """
        pass
        
    def get_averaged_value(self,noOfSamples=10):
        vals = self.aTimeline[-noOfSamples:]
        count = len(vals)
        if count>0:
            return float(sum(vals))/len(vals)
        else:
            return self.get_value()
            
    def get_stddev_value(self,noOfSamples=10):
        vals = self.aTimeline[-noOfSamples:]
        return stddev(vals)
        
    def get_value(self,iTickBacks=0):
        """
            This ist the output signal of this node.
            
            Returns the actual value (iTickBacks==0)
            or other values back in the time line.
        """
        return self._get_timeline(iTickBacks)
        
    def get_history(self):
        return self.aHistoryCache
        
    def _push_value(self,aValue):
        """
            Will be called from framework only.
        """
        self._push_timeline(aValue)
        if self.fcnValueProducer!=None:
            self.fcnValueProducer(aValue)
        
    def clock_init(self):
        """
            Will be called once before the processing starts.
            Could be used to optimize processing (cache values, etc.).
        """
        pass
        
    def clock_tick(self):
        """
            Will be called for each clock tick in processing mode.
            Must return a value representing the actual signal level.
        """
        return None     # means undefined for this generic node

    def _do_clock_tick(self):
        val = self.clock_tick()
        if is_debug():
            print( "TICK",self.get_name(),"value =",val ) #,"stddev=",self.get_stddev_value() 
        return val

    def _get_timeline(self,iTickBacks=0):
        if abs(iTickBacks)>len(self.aTimeline)-1:	# or iTickBacks<0
            return None
        return self.aTimeline[-1-abs(iTickBacks)]   # return the last element of the timeline
                
    def _push_timeline(self,aValue):
        self.aTimeline.append(aValue)        
        self._verify_timeline()
        
    def _verify_timeline(self):
        if len(self.aTimeline)>self.MAX_TIMELINE_ELEMENTS:
            self.aTimeline = self.aTimeline[len(self.aTimeline)-self.MAX_TIMELINE_ELEMENTS:]

# *************************************************************************
class TemperatureMeasurement(SignalProcessor):

    def __init__(self,sName,aArduino,bNewHeatingcontrolBoardDetected,bTestQualityOfADCs):
        super(TemperatureMeasurement,self).__init__(sName)
        self.aArduino = aArduino
        self.aActValuesT = None
        self.bNewHeatingcontrolBoard = bNewHeatingcontrolBoardDetected
        self.bTestQualityOfADCs = bTestQualityOfADCs
        self.MAX_CHANNELS = 16 # if bNewHeatingcontrolBoardDetected else 12 # since 25.11.2018 the ArduinoMega also supports 16 channels (problem with CONVERTER channel)
        if self.bTestQualityOfADCs:
            self.MAX_CHANNELS = 16+8
        self.iCount = 0             # tick count for simulation modus without arduino hardware

    def node_type(self):
        return LAYER_INPUT

    def finish(self):
        super(TemperatureMeasurement,self).finish()
        if self.aArduino:
            self.aArduino.finish()

# TODO --> wird das ueberhaupt noch benoetigt, da wir nun direkt bei der RS232 Kommunikation abfangen sollte dies hier nie mehr aufgerufen werden ?
    def reset_arduino(self):
        sRs232Name = self.aArduino.sRs232Name if self.aArduino else "???"
        append_to_logfile("RESET_ARDUINO "+sRs232Name,is_debug())
        if self.aArduino:
            self.aArduino.reopen()

    def clock_tick(self):
        ok,sLine = self._read_all(self.MAX_CHANNELS)        # we need only the side effect --> cache object for temperature measurements
        if self.bTestQualityOfADCs and ok:
            self._add_to_quality_data_file("adc_quality.csv",sLine)
        return None

    def get_channel_fcn(self,iChannel):
        ret = functools.partial(self.get_channel,iChannel)
        ret.get_node_name = lambda: f'{self.__class__.__name__}_get_channel_fcn_{iChannel}_'        
        return ret

    def get_channel(self,iChannel):
        return self.aActValuesT[iChannel]

    def _add_to_quality_data_file(self,sFileName,sLine):
        qualityFile = open(sFileName,"a")
        qualityFile.write(sLine)
        qualityFile.close()

    def _try_read(self,sLine):
        iTryCount = 0
        # 10.4.2023: Improvement for Python3 -> check for unkown command and retry last command 
        while (sLine=="" or sLine is None or sLine.startswith("ERROR: unknown command:")) and iTryCount<15:   # org: 3 (until 1.1.2018)
            sLine = self._read_data()
            if iTryCount>0:
                time.sleep(0.2)
            iTryCount += 1
        return sLine
            
    def _read_data(self):
        if self.aArduino:
            #self.aArduino.flushInput()
            #self.aArduino.flushOutput()
            #self.aArduino.reset()
            return self.aArduino.read_temperatures()
        else:
            # for simulation without arduino hardware
            if g_bTest:
                self.iCount += 1
                if self.bNewHeatingcontrolBoard:
                    if self.bTestQualityOfADCs:
                        return "Ch0=25.46;Ch1=65.66;Ch2=7.12;Ch3=28.86;Ch4=41.27;Ch5=38.59;Ch6=14.96;Ch7=81.04;Ch8=20.68;Ch9=-71.00;Ch10=5.32;Ch11=23.12;Ch12=28.86;Ch13=28.86;Ch14=28.86;Ch15=28.86;Ch16=31.12;Ch17=31.12;Ch18=31.12;Ch19=31.12;Ch20=31.12;Ch21=31.12;Ch22=31.12;Ch23=31.12;"+str(self.iCount)
                    else:
                        return "Ch0=25.46;Ch1=65.66;Ch2=7.12;Ch3=28.86;Ch4=41.27;Ch5=38.59;Ch6=14.96;Ch7=81.04;Ch8=20.68;Ch9=-71.00;Ch10=5.32;Ch11=23.23;Ch12=28.86;Ch13=28.86;Ch14=28.86;Ch15=28.86;"+str(self.iCount)
                else:
                    #org: return "Ch0=25.46;Ch1=65.66;Ch2=7.12;Ch3=28.86;Ch4=81.27;Ch5=78.59;Ch6=14.96;Ch7=81.04;Ch8=20.68;Ch9=-71.00;Ch10=1023.00;Ch11=1023.00;"+str(self.iCount)
                    return "Ch0=25.46;Ch1=65.66;Ch2=7.12;Ch3=28.86;Ch4=41.27;Ch5=38.59;Ch6=14.96;Ch7=81.04;Ch8=20.68;Ch9=-71.00;Ch10=5.32;Ch11=23.00;"+str(self.iCount)
            else:
                return ""

    def _read_all(self,iCount):
        # Ch0=25.46;Ch1=65.66;Ch2=17.12;Ch3=28.86;Ch4=81.27;Ch5=78.59;Ch6=14.96;Ch7=81.04;Ch8=20.68;Ch9=-71.00;Ch10=1023.00;Ch11=1023.00;0
        # Ch0=25.74;Ch1=65.66;Ch2=16.95;Ch3=28.85;Ch4=81.29;Ch5=78.56;Ch6=15.04;Ch7=81.00;Ch8=20.81;Ch9=-71.00;Ch10=1023.00;Ch11=1023.00;1
        # Ch0=24.47;Ch1=65.64;Ch2=17.20;Ch3=28.85;Ch4=81.30;Ch5=78.57;Ch6=14.93;Ch7=81.03;Ch8=20.71;Ch9=-71.00;Ch10=1023.00;Ch11=1023.00;2
        sLine = ""
        sLine = self._try_read(sLine)
        if sLine=="":
            self.reset_arduino()
            sLine = self._try_read(sLine)
        try:
            if len(sLine)>0:
                aValues = sLine.split(";")
                self.aActValuesT = [float(aValues[i].split("=")[1]) for i in range(iCount)]
                self.aActValuesT.append(aValues[-1].strip())     # append counter from arduino
                self.aActValuesT.append(len(sLine))      # append length of arduino return string 
                return True,sLine
            else:
                self.aActValuesT = [0 for i in range(iCount)]
                self.aActValuesT.append(0)
                self.aActValuesT.append(0)
                return False,sLine
        except Exception as aExc:
            self.aActValuesT = [0 for i in range(iCount)]
            self.aActValuesT.append(0)
            self.aActValuesT.append(0)
            append_to_logfile("EXCEPTION in _read_all "+str(aExc),is_debug())
            append_to_logfile("LINE=>"+str(sLine)+"< len="+str(len(sLine)),is_debug())
            raise aExc
            return False,sLine       

# *************************************************************************
class Timeline(SignalProcessor):

    def __init__(self,sName):
        super(Timeline,self).__init__(sName)

    def clock_tick(self):
        aNow = datetime.datetime.now()
        return aNow

# *************************************************************************
class Watchdog(SignalProcessor):

    def __init__(self,sName):
        super(Watchdog,self).__init__(sName)
        self.sOriginalName = sName

    def clock_tick(self):
        aNow = datetime.datetime.now()
        aTime = aNow.time()
        # restart heatingconrol and gui on every monday 12:05
        if aNow.weekday()==0 and aTime.hour==12 and aTime.minute==5:
            self.sName = "RESTART"      # WATCHDOG name will be changed in RESTART to signal HTTP Server a restart of the gui
            return "NOW"
        else:
            # reset object name to original one... --> bugfix for crashing QtControlGui
            self.sName = self.sOriginalName
        return None

# *************************************************************************
class RelaisMeasurement(SignalProcessor):

    MAX_CHANNELS = 8

    def __init__(self,sName,aRelaisRS232):
        super(RelaisMeasurement,self).__init__(sName)
        self.aRelaisRS232 = aRelaisRS232

    def node_type(self):
        return LAYER_OUTPUT

# TODO --> wird das ueberhaupt noch benoetigt, da wir nun direkt bei der RS232 Kommunikation abfangen sollte dies hier nie mehr aufgerufen werden ?
    def reset_relais(self):
        sRs232Name = self.aRelaisRS232.sRs232Name if self.aRelaisRS232 else "???"
        append_to_logfile("RESET_RELAIS "+sRs232Name,is_debug())
        if self.aRelaisRS232:
            self.aRelaisRS232.reopen()
        
    # delegate to aRelaisRS232 object 
    def switch_port_fcn(self,iChannel):
        ret_fcn = None
        if self.aRelaisRS232:
            ret_fcn = self.aRelaisRS232.switch_port_fcn(iChannel)
        else:
            # simulate relais object if no hardware is available
            ret_fcn = functools.partial(self.dummy_switch_port,iChannel)
        ret_fcn.get_node_name = lambda: f'{self.__class__.__name__}_switch_port_fcn{iChannel}_'        
        return ret_fcn

    # delegate to aRelaisRS232 object 
    def three_switch_port_fcn(self,iChannelOpen,iChannelClose):
        ret_fcn = None
        if self.aRelaisRS232:
            ret_fcn = self.aRelaisRS232.three_switch_port_fcn(iChannelOpen,iChannelClose)
        else:
            # simulate relais object if no hardware is available
            ret_fcn = functools.partial(self.dummy_three_switch,iChannelOpen,iChannelClose)
        ret_fcn.get_node_name = lambda: f'{self.__class__.__name__}_switch_port_fcn{iChannelOpen}_{iChannelClose}_'        
        return ret_fcn

    def switch_port_for_not_value_fcn(self,iChannel):
        ret_fcn = None
        if self.aRelaisRS232:
            ret_fcn = self.aRelaisRS232.switch_port_for_not_value_fcn(iChannel)
        else:
            # simulate relais object if no hardware is available
            ret_fcn = functools.partial(self.dummy_switch_port_for_not_value,iChannel)
        ret_fcn.get_node_name = lambda: f'{self.__class__.__name__}_switch_port_fcn{iChannel}_'        
        return ret_fcn
        
    def switch_virtual_port_fcn(self,iVirtualChannel):
        ret_fcn = None
        if self.aRelaisRS232:
            ret_fcn = self.aRelaisRS232.switch_virtual_port_fcn(iVirtualChannel)
        else:
            # simulate relais object if no hardware is available
            ret_fcn = functools.partial(self.dummy_virtual_switch_port,iVirtualChannel)
        ret_fcn.get_node_name = lambda: f'{self.__class__.__name__}_switch_port_fcn{iVirtualChannel}_'        
        return ret_fcn

    def dummy_three_switch(self,iChannelOpen,iChannelClose,iValue):
        return False

    def dummy_switch_port(self,iChannel,bValue):
        return False

    def dummy_switch_port_for_not_value(self,iChannel,bValue):
        return False

    def dummy_virtual_switch_port(self,iChannel,bValue):
        return False

    def finish(self):
        super(RelaisMeasurement,self).finish()
        if self.aRelaisRS232:
            self.aRelaisRS232.finish()

    def clock_tick(self):
        ret = None
        if self.aRelaisRS232:
            # same wokaround handling as for arduino
            try:
                ret = self.aRelaisRS232.update_status()
            except Exception as e:
                append_to_logfile(f"ERROR in RelaisMeasurement.clock_tick() exception: {e} time:"+str(datetime.datetime.now()),is_debug())
                self.reset_relais()
                if self.aRelaisRS232:
                    ret = self.aRelaisRS232.update_status()
        return ret
        
# *************************************************************************
class DataSource(SignalProcessor):

    def __init__(self,sName,fcnDataSource=None):
        super(DataSource,self).__init__(sName)
        self.fcnDataSource = fcnDataSource

    def clock_tick(self):
        if self.fcnDataSource!=None:
            return self.fcnDataSource()
        else:
            return None
        
# *************************************************************************
class Esp32HttpTemperature(DataSource):

    def __init__(self,sName):
        super(Esp32HttpTemperature,self).__init__(sName,fcnDataSource=self.read_temperature)
        self.last_value = -1.0

    def read_temperature(self):
        url = "http://192.168.178.50"
        try:
            response = requests.get(url, timeout=3)
            if response.status_code == 200:
                txt = response.text
                TEMPERATURE = "Temperature:"
                pos_start = txt.find(TEMPERATURE)
                pos_stop = txt.find("&deg;")
                if pos_start>=0 and pos_stop>=0:
                    val = float(txt[pos_start+len(TEMPERATURE):pos_stop])
                else:
                    val = 0.0
                self.last_value = val
                return val
        except requests.Timeout:
            pass
        except requests.RequestException as e:
            print("Error in read_temperature() via requests:", e)
        except Exception as e:
            print("Error in read_temperature():", e)
        return self.last_value

# *************************************************************************
class TickCounterSource(DataSource):

    def __init__(self,sName):
        super(TickCounterSource,self).__init__(sName,fcnDataSource=self.update_count)
        self.iCount = 0
                
    def update_count(self):
        self.iCount += 1
        return self.iCount
        
# *************************************************************************
class EnableTimer(SignalProcessor):     # new since 22.10.2010 

    def __init__(self,sName,lstStartStopTimeTuples,returnNoneIfOff=False):
        """
            Tuples could be (Start,Stop) or (Start,Stop,[weekday1,weekday2,...]).
            Item in tuple may be datetime.time or datetime.date or datetime.datetime
        """
        super(EnableTimer,self).__init__(sName)
        self.lstStartStopTimeTuples = lstStartStopTimeTuples
        self.returnNoneIfOff = returnNoneIfOff

    def _get_current_date_intervals(self, current_year):

        # shift time interval in reference year (2010) into time interval of current year, i. e. 2021
        # 11.2009 -> 11.2020
        #  3.2010 ->  3.2021
        #  6.2011 ->  6.2022
        def replace_ref_with_cur_year(ref_date, current_year):
            cur_date = ref_date
            if type(ref_date)==datetime.date:
                cur_date = datetime.date(current_year+(ref_date.year-START_YEAR), ref_date.month, ref_date.day)
            if type(ref_date)==datetime.datetime:
                cur_date = datetime.datetime(current_year+(ref_date.year-START_YEAR), ref_date.month, ref_date.day, ref_date.hour, ref_date.minute, ref_date.second)
            return cur_date

        # replace reference year with current year
        ret = []
        for e in self.lstStartStopTimeTuples:
            aNewStartValue = replace_ref_with_cur_year(e[0], current_year)
            aNewStopValue = replace_ref_with_cur_year(e[1], current_year)
            if len(e)>2:
                data = tuple([aNewStartValue, aNewStopValue] + list(e[2:]))   # add the rest of the tuple to the result, i. e. add the weekday list (like [5,6])
            else:
                data = (aNewStartValue, aNewStopValue)
            ret.append( data )
        return ret

    def get_additional_data_items(self):
        sIntervals = "" #str(self.lstStartStopTimeTuples)
        aNow = datetime.datetime.now()
        for e in self._get_current_date_intervals(aNow.year):
            sDays = ""
            if len(e)>2:
                sDays = str(e[2])
            sIntervals += "start=" + str(e[0]) + " stop=" + str(e[1]) + " " + sDays + ",<br>"
        return {self.get_name()+'_INTERVALS':sIntervals}
        
    def clock_tick(self):
        aNow = datetime.datetime.now()
        aTime = aNow.time()
        aDate = aNow.date()
        aWeekday = aNow.weekday()
        for e in self._get_current_date_intervals(aNow.year):
            aCurrentValue = aTime
            aStartValue = e[0]
            aStopValue = e[1]
            if type(aStartValue)==datetime.date:
                aCurrentValue = aDate
            if type(aStartValue)==datetime.datetime:
                aCurrentValue = aNow
            # if one time/date interval fits --> return 1
            # only time/date interval check
            if len(e)==2 and aCurrentValue>=aStartValue and aCurrentValue<=aStopValue:
                return 1
            # weekday and time/date interval check
            if len(e)>2 and (aWeekday in e[2]) and aCurrentValue>=aStartValue and aCurrentValue<=aStopValue:
                return 1
        # if we reach this point, then we want to return 0 == False -> convert return value to None if requested
        if self.returnNoneIfOff:
            return None
        return 0
 
# *************************************************************************
class AndNode(SignalProcessor):     # new since 4.1.2019 

    def __init__(self,sName,lstNodes,defaultValueForNone = 1):
        super(AndNode,self).__init__(sName)
        self.lstNodes = lstNodes
        self.defaultValueForNone = defaultValueForNone
        # add all nodes to the input signals dictionary
        count = 0
        for node in self.lstNodes:
            count += 1
            self.aInputSignals['node_'+str(count)] = node

    def clock_tick(self):
        """
            And operator for nodes -> true <-> value != 0; False otherwise => returns 0 or 1
            If all operands are None -> returns None
        """
        value = 1
        all_none = True
        for e in self.lstNodes:
            v = e.get_value() #clock_tick()
            if v==None:
                v = self.defaultValueForNone  # do not influence the result if value is None !
            else:
                all_none = False
                v = int(v)
            #value = value and v               # or e.get_value() but this is maybe the last value because framework has not evaluated all nodes yet in this clock tick
            value = 1 if value!=0 and v!=0 else 0
        if all_none:
            return None
        return value       
 
# *************************************************************************
class OrNode(SignalProcessor):     # new since 4.1.2019 

    def __init__(self,sName,lstNodes,defaultValueForNone = 0):
        super(OrNode,self).__init__(sName)
        self.lstNodes = lstNodes
        self.defaultValueForNone = defaultValueForNone
        # add all nodes to the input signals dictionary
        count = 0
        for node in self.lstNodes:
            count += 1
            self.aInputSignals['node_'+str(count)] = node

    def clock_tick(self):
        """
            Or operator for nodes -> true <-> value != 0; False otherwise => returns 0 or 1
            If all operands are None -> returns None
        """
        value = 0
        all_none = True
        for e in self.lstNodes:
            v = e.get_value() #clock_tick()            
            if v==None:
                v = self.defaultValueForNone  # do not influence the result if value is None !
            else:
                all_none = False
                v = int(v)
            #value = value or v                # or e.get_value() but this is maybe the last value because framework has not evaluated all nodes yet in this clock tick
            value = 1 if value!=0 or v!=0 else 0
        if all_none:
            return None
        return value       
 
# *************************************************************************
class NotNode(SignalProcessor):     # new since 4.1.2019 

    def __init__(self,sName,aNode):
        super(NotNode,self).__init__(sName)
        self.aNode = aNode
        self.aInputSignals['not_node'] = self.aNode

    def clock_tick(self):
        value = self.aNode.get_value() #clock_tick()            # or e.get_value() but this is maybe the last value because framework has not evaluated all nodes yet in this clock tick
        if value==None:
            return None
        return 1 if int(value)==0 else 0
 
# *************************************************************************
class CompareToValueNode(SignalProcessor):     # new since 5.10.2024

    def __init__(self,sName,aNode,aValue,aCompareOp = lambda a, b: a == b):
        super(CompareToValueNode,self).__init__(sName)
        self.aNode = aNode
        self.aValue = aValue
        self.aCompareOp = aCompareOp
        self.aInputSignals['compare_to_value_node'] = self.aNode

    def clock_tick(self):
        _current_val = self.aNode.get_value()
        if _current_val is not None:
            value = type(self.aValue)(_current_val) if self.aValue is not None else _current_val
        else:
            value = _current_val
        return 1 if self.aCompareOp(value,self.aValue) else 0
 
# *************************************************************************
class OperatingHoursCounter(SignalProcessor):     # new since 8.1.2024 

    MAX_DAY_HISTOGRAM_LENGTH = 14

    def __init__(self,sName,aNode,init_value=0.0):
        super(OperatingHoursCounter,self).__init__(sName)
        self.aNode = aNode
        self.dOperatingHoursCounter = init_value
        self.lstDayHistogram = []
        self.aLastTickDate = datetime.datetime.now().date()
        self.iCurrentTickCount = 0
        self.iMaxTickCountForSave = int(60.0 / ControlEngine.DELAY) # write file once a minute
        self.dLastTickPerfCounter = None
        self._load_data()
        self.aInputSignals['node'] = self.aNode

    def run_persistence(self):
        self._save_data()

    def clock_tick(self):
        current_tick = time.perf_counter()
        current_tick_date = datetime.datetime.now().date()
        current_value = self.aNode.get_value()
        is_running = int(current_value) == 1 if current_value is not None else False
        if is_running:
            self.dOperatingHoursCounter += ControlEngine.DELAY if self.dLastTickPerfCounter is None else current_tick-self.dLastTickPerfCounter
            self.dLastTickPerfCounter = current_tick
            self.iCurrentTickCount += 1
            if self._check_for_write_data():
                self._save_data()
        else:
            self.dLastTickPerfCounter = None
        if current_tick_date > self.aLastTickDate:
            self._add_to_histogram(self.dOperatingHoursCounter)
        self.aLastTickDate = current_tick_date
        return (self.dOperatingHoursCounter,self.lstDayHistogram)

    def _add_to_histogram(self,value):
        if len(self.lstDayHistogram) >= self.MAX_DAY_HISTOGRAM_LENGTH:
            # if list becomes to large -> remove oldes day value from list -> this is the first element
            del self.lstDayHistogram[0]
        self.lstDayHistogram.append(value)

    def _load_data(self):
        sFileName = self._get_filename()
        if os.path.exists(sFileName):
            ok,data = read_data(sFileName)
            if ok:
                self._set_persistence_data(data)

    def _save_data(self):
        data = self._get_persistence_data()
        write_data(self._get_filename(), data)

    def _set_persistence_data(self,data):
        self.dOperatingHoursCounter = data[0]
        if len(data)>1:
            self.lstDayHistogram = data[1]

    def _get_persistence_data(self):
        return (self.dOperatingHoursCounter,self.lstDayHistogram)

    def _get_filename(self):
        return add_sdcard_path_if_available(g_sPersistencePath+os.sep+self.get_name()+PERSISTENCE_EXTENSION)

    # write the persistent value to file only every 60 seconds, or every 5 minutes...
    def _check_for_write_data(self):
        if self.iCurrentTickCount >= self.iMaxTickCountForSave:
            self.iCurrentTickCount = 0
            return True
        return False

# *************************************************************************
class TemperatureSource(DataSource):

    def __init__(self,sName,fcnDataSource=None,dValueForJumpCheck=None,bCheckForShift=False):
        super(TemperatureSource,self).__init__(sName,fcnDataSource)
        self.dValueForJumpCheck = dValueForJumpCheck
        self.bCheckForShift = bCheckForShift
        self.dLastGoodValue = None
        self.dShift = 0.0
        self.aInputSignals['data_source'] = fcnDataSource
        
    def node_type(self):
        return LAYER_INPUT

#    def clock_tick_for_jump(self):
#        value = super(TemperatureSource,self).clock_tick()              # 18.0
#        if self.dValueForJumpCheck!=None and self.dLastGoodValue!=None: # lastVaue = 8.0
#            delta = value - self.dLastGoodValue                         # delta = 10.0
#            #self.dLastGoodValue = value                                # do not update last value ! so only one jump 
#            if math.fabs(delta)>=self.dValueForJumpCheck:               # jumpCheck = 7.5 
#                value = value - delta                                   # newValue = 18.0 - 10.0 = 8.0
#        else:
#            self.dLastGoodValue = value
#        return value

    def clock_tick(self):
        value = super(TemperatureSource,self).clock_tick()              # switch-down: value < 5.0    # switch-up: value > 12.5
        if self.bCheckForShift:
            #if value<-2.0:
            #    self.dShift = 0.0
            #el
            if value<6.5:
                self.dShift = 0.0
            elif value>12.5:
                self.dShift = 11.0
            value = value - self.dShift
        return value
        
# *************************************************************************
class LightSource(DataSource):

    def __init__(self,sName,fcnDataSource=None):
        super(LightSource,self).__init__(sName,fcnDataSource)
        
# *************************************************************************
class ThermicalSolarCollectorControl(SignalProcessor):        

    INPUT_ID_SOLAR = "solar"
    INPUT_ID_BUFFER = "buffer"
    INPUT_ID_MANUAL_RESET = "reset"     # new since 27.10.2010: if the manual switch is activated --> reset minimum run time !
    
    DELTA_TEMP = 5.0
    MAX_TEMP = 95.0
    MIN_RUN_TIME = 180.0     # in seconds

    def __init__(self,sName,dDelta=DELTA_TEMP):
        super(ThermicalSolarCollectorControl,self).__init__(sName)
        self.dDelta = dDelta
        self.dLastSwitchChange = None
        self.iLastValue = None
        self.aManualInputNode = None

    def node_type(self):
        return LAYER_CONTROL

    def clock_init(self):
        self.aTempSolarNode = self.get_input(self.INPUT_ID_SOLAR)
        self.aTempBufferNode = self.get_input(self.INPUT_ID_BUFFER)
        self.aManualInputNode = self.get_input(self.INPUT_ID_MANUAL_RESET)
    
    def clock_tick(self):    
        # 27.10.2010
        # an activated manual switch (overwrite of the automatic control) must reset the minimum run time
        # because if we disable the manual switch again we want to evaluate the measurments for the control process
        # otherwise the switch may be set to 1 again !
        if self.aManualInputNode!=None and self.aManualInputNode.is_activated():
            self.dLastSwitchChange = None
        # is control enabled --> first time or last switch is at least 60s in the past 
        if self.dLastSwitchChange==None or time.time()-self.dLastSwitchChange>self.MIN_RUN_TIME:
            #if self.aTempSolarNode.get_value()>self.aTempBufferNode.get_value()+self.dDelta:
            dAverage = self.aTempSolarNode.get_averaged_value()
            # switch on: (solar temperature > buffer temperature + 5) AND (buffer temperature < 95 grad)
            dTemp = self.aTempBufferNode.get_value()
            if dAverage>dTemp+self.dDelta and dTemp<self.MAX_TEMP:                
                iNewValue = 1
            # switch off: solar temperature < buffer temperature + 2.5
            elif dAverage<self.aTempBufferNode.get_value()+self.dDelta*0.5:
                iNewValue = 0
            else:
                iNewValue = self.iLastValue
            if self.iLastValue!=iNewValue:
                self.dLastSwitchChange = time.time()
                self.iLastValue = iNewValue
        return self.iLastValue

# *************************************************************************
class HeatingControl(SignalProcessor):

    INPUT_ID_OUTDOOR = "outdoor"

    SWITCH_ON_TEMP = 10.0    # Grad Celsius

    MIN_RUN_TIME = 180.0     # in seconds

    def __init__(self,sName,dSwitchOnTemp=SWITCH_ON_TEMP):
        super(HeatingControl,self).__init__(sName)
        self.dSwitchOnTemp = dSwitchOnTemp
        self.dLastSwitchChange = None
        self.iLastValue = None

    def node_type(self):
        return LAYER_CONTROL

    def get_additional_data_items(self):
        return {self.get_name()+'_SWITCH_ON_TEMP':self.SWITCH_ON_TEMP}
        
    def clock_init(self):
        self.aTempOutdoorNode = self.get_input(self.INPUT_ID_OUTDOOR)
    
    def clock_tick(self):    
        if self.dLastSwitchChange==None or time.time()-self.dLastSwitchChange>self.MIN_RUN_TIME:
            if self.aTempOutdoorNode.get_value()<self.dSwitchOnTemp:
                iNewValue = 1
            else:
                iNewValue = 0
            if self.iLastValue!=iNewValue:
                self.dLastSwitchChange = time.time()
                self.iLastValue = iNewValue
        return self.iLastValue

# *************************************************************************
class DesiredValueForHeatingMixerControl(HeatingControl):            
    
    """
        T > 10 Grad   ==> aus
        T = 10 Grad   ==> 22 Grad 
        T = 0  Grad   ==> MAX Grad
        T < 0  Grad   ==> MAX Grad 
        
        MAX == 28.0
    """
    
    MAX_TEMPERATURE_VALUE = 28.0        # Grad Celsius
    MIN_TEMPERATURE_VALUE = 22.0        # Grad Celsius

    DELTA_TICK_COUNT = 36   # == 60 sec = 12 x 5 sec  # 180 = 36 x 5 sec == 3 min  # new since 9.1.2019

    INPUT_ID_CURRENT_VALUE = "current_value"
    INPUT_ID_ENABLE_MAX_TEMP_CONTROL = "temperature_control"
    
    def __init__(self,sName,dSwitchOnTemp=HeatingControl.SWITCH_ON_TEMP):
        super(DesiredValueForHeatingMixerControl,self).__init__(sName,dSwitchOnTemp)
#        self.m = -0.5  # until 22.11.2010: -0.6    # until 9.11.2010: -0.6666666     # -1.0    # -0.75
#        self.b = 31.5  # until 22.11.2010: 29.5    # until 9.11.2010: 28.5           # 32.0    # 26.5
#        self.m = -0.675  # -0.75   # -0.6666666     # -1.0
#        self.b = 28.0   #26.5   # 28.5           # 32.0
        self.m = -0.5     # new since 5.11.2012
        self.b = self.MAX_TEMPERATURE_VALUE        
        self.dFixedValue = None
        self.aControlTargetTemperature = 36.0  # Grad Celsius
        self.aControlStep = 0.5                # Grad Celsius
        self.aTickCount = 0
        self.aTickCountLastAction = 0
        self._load_data()

    def node_type(self):
        return LAYER_CONTROL

    def run_persistence(self):
        self._save_data()

    def _load_data(self):
        sFileName = self._get_filename()
        if os.path.exists(sFileName):
            ok,data = read_data(sFileName)
            if ok:
                self._set_persistence_data(data)
        
# TODO --> dieser Wert wird haeufig geschrieben --> ggf. Probleme bei Stromausfall !!!        
    def _save_data(self):
        data = self._get_persistence_data()
        write_data(self._get_filename(), data)
        
    def _set_persistence_data(self,data):
        self.b = data[0]
        self.m = data[1]
        self.aControlTargetTemperature = data[2]
        self.aControlStep = data[3]
        
    def _get_persistence_data(self):
        return (self.b,self.m,self.aControlTargetTemperature,self.aControlStep)

    def _get_filename(self):
        return add_sdcard_path_if_available(g_sPersistencePath+os.sep+self.get_name()+PERSISTENCE_EXTENSION)

    def _do_action(self):
        """
            Implement the time constant for control operation.
        """
        self.aTickCount += 1
        # is the time interval for the next control operation expired `
        if self.aTickCount>=self.aTickCountLastAction+self.DELTA_TICK_COUNT:
            self.aTickCountLastAction = self.aTickCount
            # Yes --> do next control operation
            return True
        return False
        
    def _is_control_enabled(self):
        if self.aEnableMaxTempControlSwitch!=None and self.aEnableMaxTempControlSwitch.is_activated():
            return self.aEnableMaxTempControlSwitch.get_value()!=None and int(self.aEnableMaxTempControlSwitch.get_value())>0
        return False

    def _process_control(self):
        if self._is_control_enabled():
            if self._do_action():
                actVal = self.aTemperatureOfBuffer.get_value() if self.aTemperatureOfBuffer else None
                if actVal!=None:
                    if actVal<self.aControlTargetTemperature:
                        newMaxValue = self.get_max_value()-self.aControlStep
                        self.set_max_value(newMaxValue)
                    elif actVal>self.aControlTargetTemperature+0.5:
                        newMaxValue = self.get_max_value()+self.aControlStep
                        self.set_max_value(newMaxValue)
        else:
            # Reset self.b to default value if control is disabled !!!
            self.set_max_value(self.MAX_TEMPERATURE_VALUE)

    def _calc(self,val):
        #if val<-20.0:
        #    return 42.0
        #if val<-4.5:        # new since 14.12.2010      # -2.0:            # new since 4.12.2010
        #    return 31.0     # 30.0
        if val<0.0:          # new since 7.2.2011
            return min(self.MAX_TEMPERATURE_VALUE,self.b)      # we do not reach temperatures above this value
        return round((self.m*val+self.b)*2.0)*0.5       # round to 0.5 --> 0, 0.5, 1, 1.5, 2, ...
            
    def _calc_for_clock_tick(self):
        if self.dFixedValue!=None:
            return self.dFixedValue
        val = self.aTempOutdoorNode.get_value()
        if val<self.dSwitchOnTemp:
            return self._calc(val)
        else:
            return None
            
    def get_additional_data_items(self):
        return { self.get_name()+'_CURRENT_DESIRED_TEMPERATURE':self._calc_for_clock_tick(),
                 self.get_name()+'_CURRENT_MAX_TEMPERATURE':self.b }
        
    def set_max_value(self,newValue):
        if newValue<=self.MAX_TEMPERATURE_VALUE and newValue>=self.MIN_TEMPERATURE_VALUE:
            self.b = newValue
            self._save_data()
            
    def get_max_value(self):
        return self.b
            
    def set_value(self,aNewState):
        if str(aNewState)=="None":
            aNewState = None
        try:
            if aNewState!=None:
                self.dFixedValue = float(aNewState)
            else:
                self.dFixedValue = aNewState # == Non
        except ValueError:
            self.dFixedValue = None
        
    def clock_init(self):
        super(DesiredValueForHeatingMixerControl,self).clock_init()
        self.aTemperatureOfBuffer = self.get_input(self.INPUT_ID_CURRENT_VALUE)
        self.aEnableMaxTempControlSwitch = self.get_input(self.INPUT_ID_ENABLE_MAX_TEMP_CONTROL)
        
    def clock_tick(self):
        self._process_control()
        return self._calc_for_clock_tick()

# *************************************************************************
class HeatingMixerControl(SignalProcessor):            

    INPUT_ID_ACTUAL_VALUE = "actual_value"
    INPUT_ID_DESIRED_VALUE = "desired_value"
    INPUT_ID_CLOSE_SIGNAL = "close_signal"
    INPUT_ID_HEATING_MOTOR = "heating_motor"

    DELTA = 0.5             # minimum derivation between actual and desired value in grad celsius 
    
# TODO --> konstanten als zeitkonstanten angeben --> verwende Konstanten zur Berechnung !    
    DELTA_TICK_COUNT = 36   # == 60 sec = 12 x 5 sec  # new 5.11.2012: 180 sec --> increased timeconstant because of oscillation !

    def __init__(self,sName,actionForMixerClosed = None,queryForMixerIsClosed = None,updateOpenTickCount = None):
        super(HeatingMixerControl,self).__init__(sName)
        self.aActionForMixerClosed = actionForMixerClosed
        self.aQueryForMixerIsClosed = queryForMixerIsClosed
        self.aUpdateOpenTickCount = updateOpenTickCount
        self.bIsMixerClosing = False
        self.aTickCount = 0
        self.aTickCountLastAction = 0

    def node_type(self):
        return LAYER_CONTROL

    def _do_action(self):
        """
            Implement the time constant for control operation.
        """
        self.aTickCount += 1
        # is the time interval for the next control operation expired `
        if self.aTickCount>=self.aTickCountLastAction+self.DELTA_TICK_COUNT:
            self.aTickCountLastAction = self.aTickCount
            # Yes --> do next control operation
            return True
        return False

    def clock_init(self):
        self.aTempActualNode = self.get_input(self.INPUT_ID_ACTUAL_VALUE)
        self.aTempDesiredNode = self.get_input(self.INPUT_ID_DESIRED_VALUE)
        self.aCloseMixerNode = self.get_input(self.INPUT_ID_CLOSE_SIGNAL)
        self.aHeatingMotorNode = self.get_input(self.INPUT_ID_HEATING_MOTOR)
        
    def clock_tick(self):    
        closeMixerSignal = self.aCloseMixerNode.get_value() if self.aCloseMixerNode!=None else None
        heatingMotor = self.aHeatingMotorNode.get_value() if self.aHeatingMotorNode!=None else None
        if closeMixerSignal!=None:
            if closeMixerSignal==1:  # process close mixer signal even if heating motor is not running !
                # check if mixer is already closed ? do nothing if mixer is closed !
                if self.aQueryForMixerIsClosed!=None and self.aQueryForMixerIsClosed():
                    return -1
                self.bIsMixerClosing = True
                return 0                            # close
            # switch state of mixer after mixer is closed
            if self.bIsMixerClosing and closeMixerSignal==0:
                self.bIsMixerClosing = False
                # set mixer state to closed
                if self.aActionForMixerClosed!=None:
                    self.aActionForMixerClosed(True)
        if self._do_action():
            actVal = self.aTempActualNode.get_value()
            desiredVal = self.aTempDesiredNode.get_value()
            if heatingMotor!=None and heatingMotor==0:
                return -1                           # stop --> heating motor is not running --> no closed loop for mixer output
            # no change if any of the control values (act. or desired) is None 
            if actVal!=None and desiredVal!=None:           
                # verify actual value with desired value and make an appropriate action
                if actVal<desiredVal-self.DELTA:
                    if self.aActionForMixerClosed!=None:
                        self.aActionForMixerClosed(False)
                    if self.aUpdateOpenTickCount!=None:
                        self.aUpdateOpenTickCount(1)
                    return +1                       # open
                elif actVal>desiredVal+self.DELTA:
                    if self.aUpdateOpenTickCount!=None:
                        self.aUpdateOpenTickCount(-1)
                    return 0                        # close
        return -1                                   # stop (nothing to do)

# *************************************************************************
class HeatPumpControl(SignalProcessor):

    INPUT_ID_BUFFER = "buffer"
    INPUT_ID_OUTGOING_AIR = "outgoingair"       # == CONVERTER
    INPUT_ID_MANUAL_SWITCH = "manual_switch"
    
# TODO -> nicht einschalten, falls Solar-Pumpe ggf. schon laenger laeuft oder die oberste Temperatur noch ueber einem Schwellwert von xy Grad liegt -> Optimierung fuer dein Einsatz von der Waermepumpe !
    TEMPERATURE_SWITCH_ON  = 37.5           # until 2.12.2010: 36.0
    TEMPERATURE_SWITCH_OFF = 41.0
    TEMPERATURE_OUTGOING_AIR = -0.5 #2.8 # PATCH FOR DEFECT CONVERTER TEMPERATURE SENSOR -0.5         # until 2.12.2010: 0.0          # Vereisungs Schutz
    
    MAX_SAFETY_MEAS_COUNT = 720             # until 2.12.2010: 480              # n Messungen nacheinander unterhalb des Safety-Ausschalt-Limits ==> Waermepumpe wirklich ausschalten !
                                            # until 7.2.2012:  600
# TODO (Optimierung) 7.2.2012: ggf. ein Integral bilden, je nachdem wie viel Temperatur unter der Schwelle liegt, um so schneller ausschalten --> je tiefer Temperaturen, desto schneller vereist Waermepumpe
                                    # 48 == 48*5sec = 4min ! (old: 2min)
  
    MIN_RUN_TIME = 720.0                    # until 2.12.2010: 600.0     # in seconds == 10 minutes !
                                            # until 7.2.2012:  900.0

    def __init__(self,sName):
        super(HeatPumpControl,self).__init__(sName)
        self.iCountMeasBelowSafetySwitchOff = 0
        self.dLastSwitchChange = None
        self.iLastValue = None

    def node_type(self):
        return LAYER_CONTROL

    def get_additional_data_items(self):
        return { self.get_name()+'_SWITCH_ON_TEMP':self.TEMPERATURE_SWITCH_ON,
                 self.get_name()+'_SWITCH_OFF_TEMP':self.TEMPERATURE_SWITCH_OFF,
                 self.get_name()+'_SWITCH_OFF_AIR_TEMP':self.TEMPERATURE_OUTGOING_AIR }
        
    def clock_init(self):
        self.aTempBufferNode = self.get_input(self.INPUT_ID_BUFFER)
        self.aTempOutgoingAirNode = self.get_input(self.INPUT_ID_OUTGOING_AIR)
        self.aManualSwitch = self.get_input(self.INPUT_ID_MANUAL_SWITCH)
        
    def clock_tick(self):
        val = self.aTempBufferNode.get_value()
        valAir = self.aTempOutgoingAirNode.get_value()
        iNewValue = self.iLastValue             # default value: nothing to do, do not change the actual state !
        # check safety switch off
        if valAir<self.TEMPERATURE_OUTGOING_AIR:
            self.iCountMeasBelowSafetySwitchOff += 1
            if self.iCountMeasBelowSafetySwitchOff>self.MAX_SAFETY_MEAS_COUNT: 
                iNewValue = 0
                self.iCountMeasBelowSafetySwitchOff = 0 
                sNow = str(datetime.datetime.now())
                append_to_logfile("ERROR: CONVERTER below 1 grad celsius ! "+sNow,is_debug())
        else:
            # at least one measurement is above the safty limit --> reset counter !
            self.iCountMeasBelowSafetySwitchOff = 0 
            # normal operation...
            # --> first check for manual overwriting
            if self.aManualSwitch!=None and self.aManualSwitch.is_activated():
                if self.aManualSwitch.get_value()!=None and int(self.aManualSwitch.get_value())>0:
                    iNewValue = 1
                else:
                    iNewValue = 0
            # --> than check for the need to switch on/off 
            elif self.dLastSwitchChange==None or time.time()-self.dLastSwitchChange>self.MIN_RUN_TIME:
                if val<=self.TEMPERATURE_SWITCH_ON:
                    iNewValue = 1
                elif val>=self.TEMPERATURE_SWITCH_OFF:
                    iNewValue = 0
#                else:
#                    # nothing to do --> leave the actual value unchanged !
#                    iNewValue = self.iLastValue     # Bugfix 8.11.2010: do not change the state  !(T<=36) and !(T>=40)
#            else:
#                iNewValue = self.iLastValue
        if self.iLastValue!=iNewValue:
            self.dLastSwitchChange = time.time()
            self.iLastValue = iNewValue
        return self.iLastValue

# *************************************************************************
class VentilationControl(SignalProcessor):

    INPUT_ID_HEATPUMP_ON = "heatpumpon"
    INPUT_ID_OUTGOING_AIR = "outgoingair"           # == CONVERTER

    TEMPERATURE_OUTGOING_AIR_MIN = 2.0              # Vereisungs Schutz, until 28.11.2010: 10.0, until 7.2.2012: 4.0             

    def __init__(self,sName):
        super(VentilationControl,self).__init__(sName)

    def node_type(self):
        return LAYER_CONTROL

    def clock_init(self):
        self.aTempOutgoingAirNode = self.get_input(self.INPUT_ID_OUTGOING_AIR)
        self.aHeatPumpOn = self.get_input(self.INPUT_ID_HEATPUMP_ON)
        
    def clock_tick(self):
# TODO --> ggf. hysterese zum Ausschalten, d.h. hoehere Temperatur zum ausschalten
# TODO --> ggf. zweiter Eingang ob Solarkreislauf auf Waermepumpe geschaltet ist
        if (self.aHeatPumpOn.get_value()!=None and self.aHeatPumpOn.get_value()>0) or self.aTempOutgoingAirNode.get_value()<self.TEMPERATURE_OUTGOING_AIR_MIN:     #self.aHeatPumpOn.get_value()>0 or
            return 1
        else:
            return 0

# *************************************************************************
class HeatPumpSolarValveControl(SignalProcessor):

    INPUT_ID_SOLAR_FOR_BUFFER = "solarforbuffer"
    INPUT_ID_COLLECTOR = "collector"
    
    MIN_COLLECTOR_TEMPERATURE = 10.0
     
    def __init__(self,sName):
        super(HeatPumpSolarValveControl,self).__init__(sName)

    def node_type(self):
        return LAYER_CONTROL

    def clock_init(self):
        self.aTempCollectorNode = self.get_input(self.INPUT_ID_COLLECTOR)
        self.aSolarForBufferOnNode = self.get_input(self.INPUT_ID_SOLAR_FOR_BUFFER)
        
    def clock_tick(self):
        if self.aSolarForBufferOnNode==None or int(self.aSolarForBufferOnNode.get_value())==1:
            return 0
        else:
            return self.aTempCollectorNode.get_input()>=self.MIN_COLLECTOR_TEMPERATURE 

# *************************************************************************
class ManualSwitch(SignalProcessor):
    
    def __init__(self,sName,aInitState=None):
        super(ManualSwitch,self).__init__(sName)
        self.set_activated(False)
        self.aState = aInitState
        self._load_data()
        verify_path(self._get_filename())

    def node_type(self):
        return LAYER_MANUAL_SWITCH

    def set_value(self,aNewState):
        if str(aNewState)=="None":
            aNewState = None
        self.aState = aNewState
        self.set_activated(aNewState!=None)
        self._save_data()

    def clock_tick(self):    
        if self.is_activated():
            return self.aState
        else:
            return None
                    
    def run_persistence(self):
        self._save_data()

    def _load_data(self):
        sFileName = self._get_filename()
        if os.path.exists(sFileName):
            ok,data = read_data(sFileName)
            if ok:
                self._set_persistence_data(data)
        
    def _save_data(self):
        data = self._get_persistence_data()
        write_data(self._get_filename(), data)
        
    def _set_persistence_data(self,data):
        self.aState = data[0]
        self.set_activated(data[1])
        
    def _get_persistence_data(self):
        return (self.aState,self.is_activated())

    def _get_filename(self):
        return add_sdcard_path_if_available(g_sPersistencePath+os.sep+self.get_name()+PERSISTENCE_EXTENSION)

# *************************************************************************
class ManualSwitchAutoReset(SignalProcessor):
    
    """
        Special class to handle a switch with pulse functionality:
        
        -1 == close, 0 == stop, 1 == open, 2 == open pulse, 3 == close pulse
        
    """
    
    def __init__(self,sName,aInitState=None):
        super(ManualSwitchAutoReset,self).__init__(sName)
        self.set_activated(False)
        self.aState = aInitState
        self.aLastState = aInitState

    def set_value(self,aNewState):
        if str(aNewState)=="None":
            aNewState = None
        self.aLastState = self.aState
        self.aState = aNewState
        self.set_activated(aNewState!=None)

    def clock_tick(self):    
        if self.is_activated():
            ret = self.aState
            # auto reset the values greater than 1
            if ret!=None and int(ret)>=2:
                self.aState = self.aLastState
            return ret
        else:
            return None
        
# *************************************************************************
#class SwitchValue(ManualSwitch):
#    
#    def __init__(self,sName,aInputForOn,aInputForOff,aInitState=None):
#        super(SwitchValue,self).__init__(sName,aInitState)
#        self.aInputForOn = aInputForOn
#        self.aInputForOff = aInputForOff
#
#    def clock_tick(self):    
#        val = self.is_activated()
#        print "----> ",self,val
#        if val:
#            return self.aInputForOn.clock_tick()
#        else:
#            return self.aInputForOff.clock_tick()
#        #if val:
#        #    return str(val)+"/"+str(self.aInputForOn.clock_tick())
#        #else:
#        #    return str(val)+"/"+str(self.aInputForOff.clock_tick())
                            
# *************************************************************************
class ValueSwitch(SignalProcessor):
    
    def __init__(self,sName,aInputForOn,aInputForOff,aManualSwitch):
        super(ValueSwitch,self).__init__(sName)
        self.aInputForOn = aInputForOn          # ManualSwitch ON
        self.aInputForOff = aInputForOff        # ManualSwitch OFF or None
        self.aManualSwitch = aManualSwitch
        self.aInputSignals['input_for_on'] = self.aInputForOn
        self.aInputSignals['input_for_off'] = self.aInputForOff
        self.aInputSignals['input_for_manual_switch'] = self.aManualSwitch

    def clock_tick(self):    
        val = self.aManualSwitch.clock_tick()
        if val==None or int(val)==0:
            return self.aInputForOff.clock_tick()
        else:
            return self.aInputForOn.clock_tick()
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
