mneuroth/heizungsregelung-public/(commit log)

2023-05-19 Initial public release
    [KennlinieNTC20.ods, VergleichBoards.ods]
2023-05-19 Added missing heizung.py file
    [heizung.py]
2023-05-23 Improved documentation for UART communication -> use PL011 instead of unstable miniuart
2024-01-13 Bugfix for OperatingHoursCounter, use get_value() instead of is_activated() and set initial operating hours for heating pump since 16.1.2023
    [heizung.py]
2024-01-18 Removed switch off times for heatpump and heating motor because of heatpump was connected to special power meter
2024-01-23 Bugfix for optimized csv file writing for OperatingHoursCounter
    [heizung.py]
2024-02-02 Bugfix: remove first element from OperatingHoursCounter histogram if histogram becames to large
    [heizung.py]
2024-02-04 Improvement for OperatingHoursCounter: use timer.perf_counter() value instead of predefined Tick-Delay
2024-02-04 Bugfix for writing cache data to usb memory stick
    [heizung.py]
2024-02-09 Bugfix for operating hour counters
    [heizung.py]
2024-02-13 Bugfix for function _resize_list_if_needed()
    [timeline_data_tracker.py]
2024-02-20 Improved pv facility exporter by adding persistence and CTRL-C signal handler, bugfix for dumping day values of pv facility exporter and for value calculation of pv to house and total house consumpti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
    [file_utils.py, heizung.py, pipeprocessing.py, pv_facility_exporter.py, pv_facility_reader.py, timeline_data_tracker.py]
2024-10-05 Added support for running heatpump only if PV is available, added support for output of graphviz diagram for documentation and added unit tests
2025-11-02 Added firmware for esp32 temperature measurement
2026-01-30 Synchronized with private project (Bugfix for reset of heizungsplatine and therefore switched off relais)
    [flask_server.py, heizung.py]
